ymahajan456/Peltier-and-CHIL/Images/20170119_235004.jpg

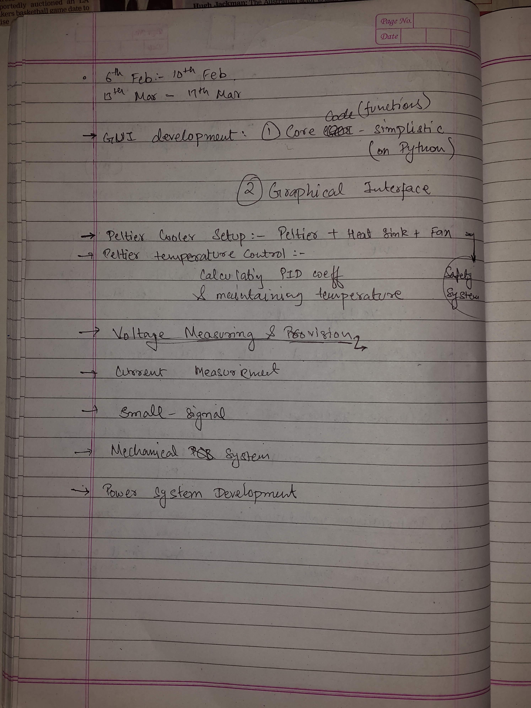
Images/20170119_235004.jpg
