ymahajan456/Peltier-and-CHIL/References/links.txt

Thermistor control of peltier voltage with Arduino (for DSLR chill box project)

http://electronics.stackexchange.com/questions/118536/thermistor-control-of-peltier-voltage-with-arduino-for-dslr-chill-box-project
.....................................................................................................................................
