ymahajan456/Peltier-and-CHIL/Documentation/Final Documentation/D16.pdf

# Temperature Controller and IV Characterizer Group Number: DD 16

## Project Guide: Prof. Joseph John

G R O U P M E M B E R S

O V S H A S H A N K 1 4 D 0 7 0 0 2 1

Y O G E S H M A H A J A N 1 4 D 0 7 0 0 2 2

A Y U S H A G R A W A L 1 4 D 0 7 0 0 4 2

# Abstract

- The aim of the project was to build a wide range temperature controller using a Peltier Cooler
- The set is to be used to plot the IV Characteristics of two terminal devices at various temperatures.
- Along with the temperature controller, the IV Characteriser was also designed as part of the project.

# Motivation

- Not an easy way to quickly characterize a devices’ characteristic at various temperatures
- Reduce the manual effort by designing an automated system
- Learn about the Peltier Cooler
- Learn precise low power system design for the IV Characteriser
- Learn coding for new microprocessors and GUI Design

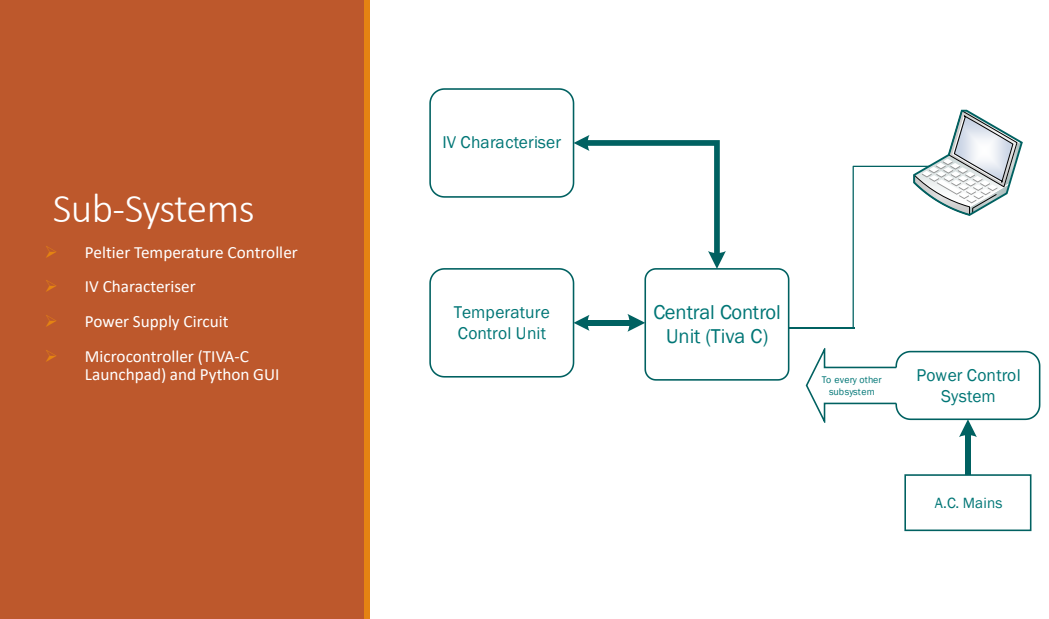
[picture p14: page 4]
Temperature Control Unit; IV Characteriser; Central Control Unit (Tiva C); Power Control System; A.C. Mains; Sub-Systems; ➢ IV Characteriser

➢ Peltier Temperature Controller

➢ Power Supply Circuit

➢ Microcontroller (TIVA-C
Launchpad) and Python GUI

To every other
subsystem

# Power Supply Circuit and TIVA Breakout

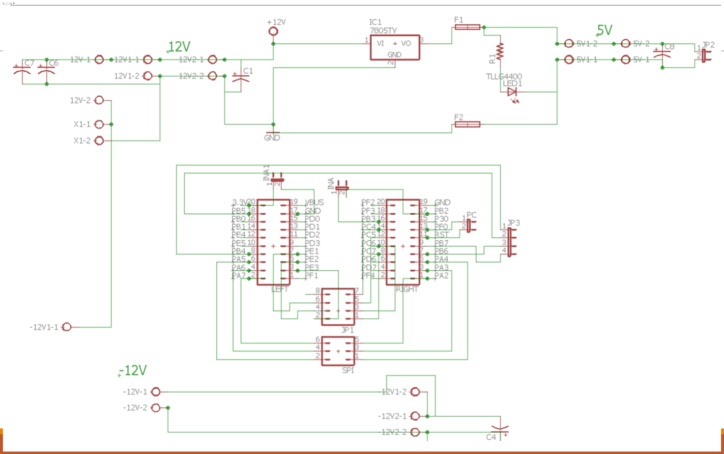
[picture p15: figure]

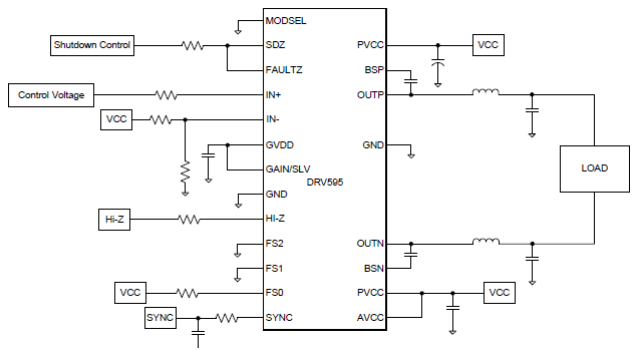
[picture p16: figure]

# DRV595

- H Bridge IC
- High Power handling capability and internal direction switching
- Testing Procedure
- Problems Faced

# Peltier Temperature Controller

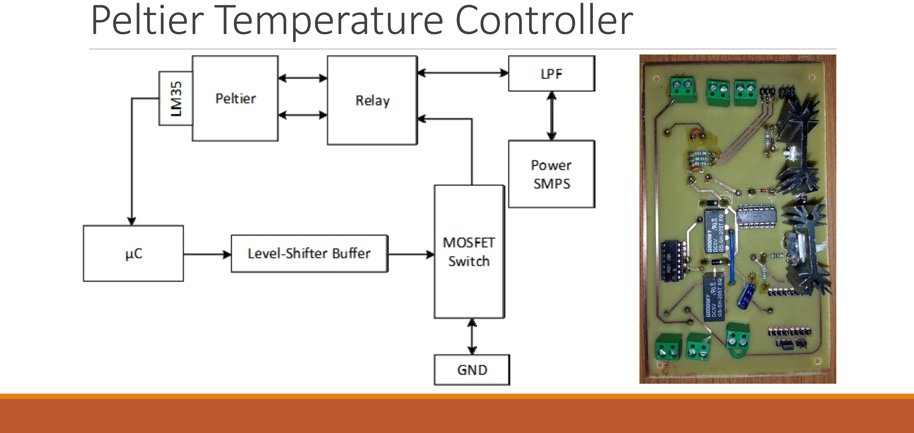
[picture p17: page 7]
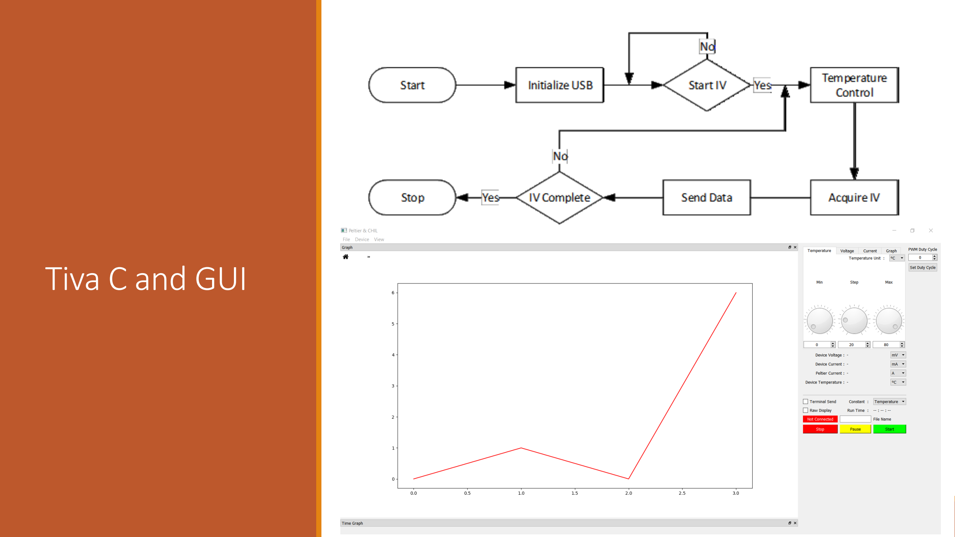
[picture p18: page 8]

# Tiva C and GUI

# IV Characteriser

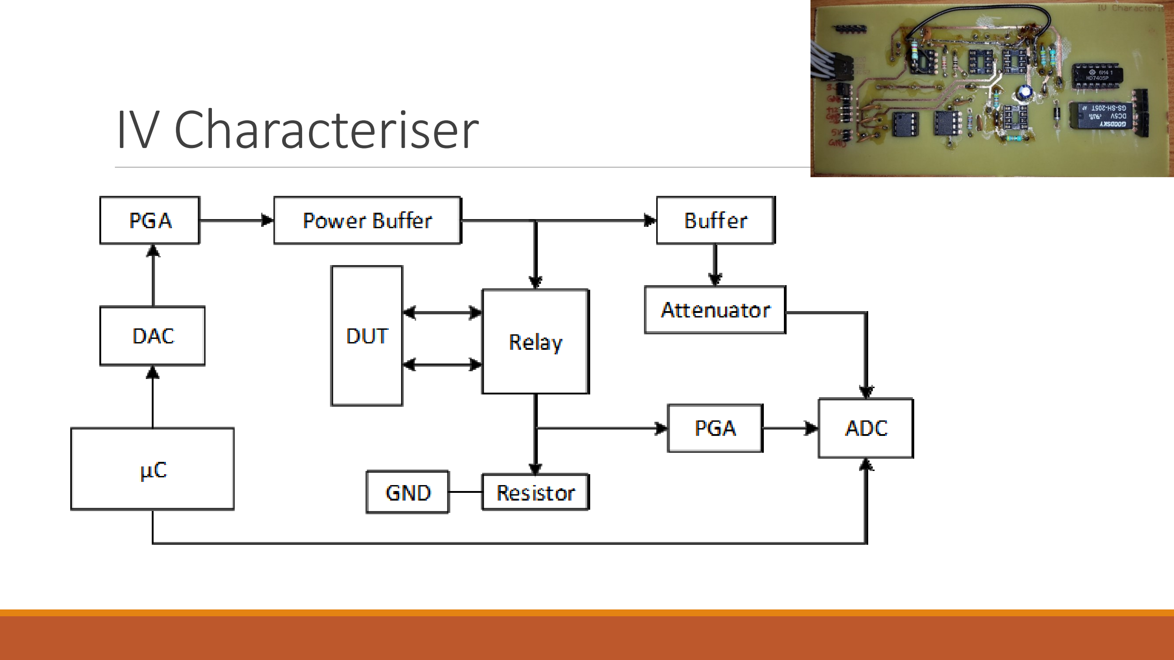
[picture p19: page 9]

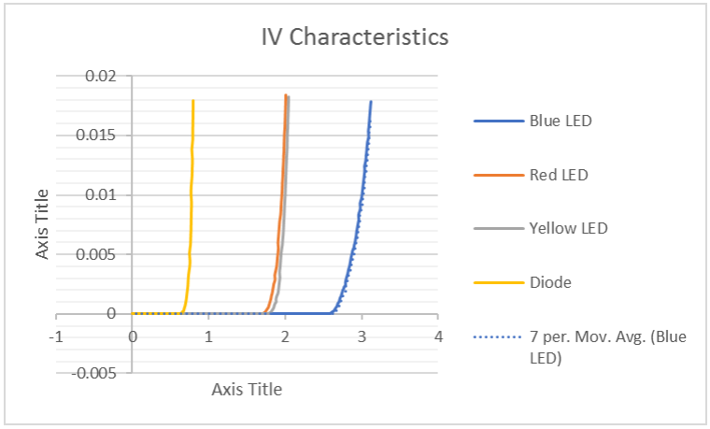
[picture p20: figure]

# Testing Results

- Peltier Temperatures were stabilised in the range of -5 degrees to 80 degrees
- Temperatures around room temperatures showed more
oscillations
- IV Characterisation was
completed and the following are the results

# Demo Details

- IV Characterisation for Diodes and Zener Diodes will be performed
- A few temperatures will be shown to stabilise along with settling time details
- Diode IV Characteristics will be plotted at a few set-point temperatures and the variation would be observed

# Future Scope

- Performing the small signal analysis of the two-terminal device
- Extend support to multi-terminal devices by applying bias to the other terminals and performing the IV Characteristics across the remaining terminals
- Temperature Control of the Peltier Cooler can be made more precise by using the double control loop
- More dynamic changes can be introduced in the IV Characteristics to make the control more robust, immune to errors and fine grained to get high standard results.
