ymahajan456/Peltier-and-CHIL/Documentation/Project Proposal/Gantt project planner.xlsx

Multi-Temperature Diode Characterizer
Unit used in the Gannt Chart is of a Day. |  |  |  |  | Period Highlight: | 1 |  |  | Plan Duration |  |  |  |  |  | Actual Start |  |  |  |  | % Complete |  |  |  |  | Actual (beyond plan) |  |  |  |  |  |  |  | % Complete (beyond plan)
ACTIVITY | PLAN START | PLAN DURATION | ACTUAL START | ACTUAL DURATION | PERCENT COMPLETE | PERIODS
 |  |  |  |  |  | 1 | 2 | 3 | 4 | 5 | 6 | 7 | 8 | 9 | 10 | 11 | 12 | 13 | 14 | 15 | 16 | 17 | 18 | 19 | 20 | 21 | 22 | 23 | 24 | 25 | 26 | 27 | 28 | 29 | 30 | 31 | 32 | 33 | 34 | 35 | 36 | 37 | 38 | 39 | 40 | 41 | 42 | 43 | 44 | 45 | 46 | 47 | 48 | 49 | 50 | 51 | 52 | 53
Peltier Cooler Setup | 1 | 3 | 0 | -1 | 25%
Component Procurement and Testing | 1 | 6 | -1 | -1 | 100%
Metal Plate Temperature Control | 4 | 3 | -1 | -1 | 35%
DUT Holder Assembly | 1 | 7 | -1 | -1 | 10%
Voltage Measurement Circuitry | 8 | 14 | -1 | -1 | 85%
Final PCB Design | 8 | 60 | -1 | -1 | 85%
Current Measurement Circuitry | 23 | 4 | -1 | -1 | 50%
GUI for I-V Characteristics | 8 | 60 | -1 | -1 | 60%
Voltage Generation Circuitry | 28 | 7 | -1 | -1 | 75%
Integrating Small Signal Analysis | 36 | 20 | -1 | -1 | 100%
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
