ymahajan456/Peltier-and-CHIL/Boards/IV_Characteristics/Schematic.png

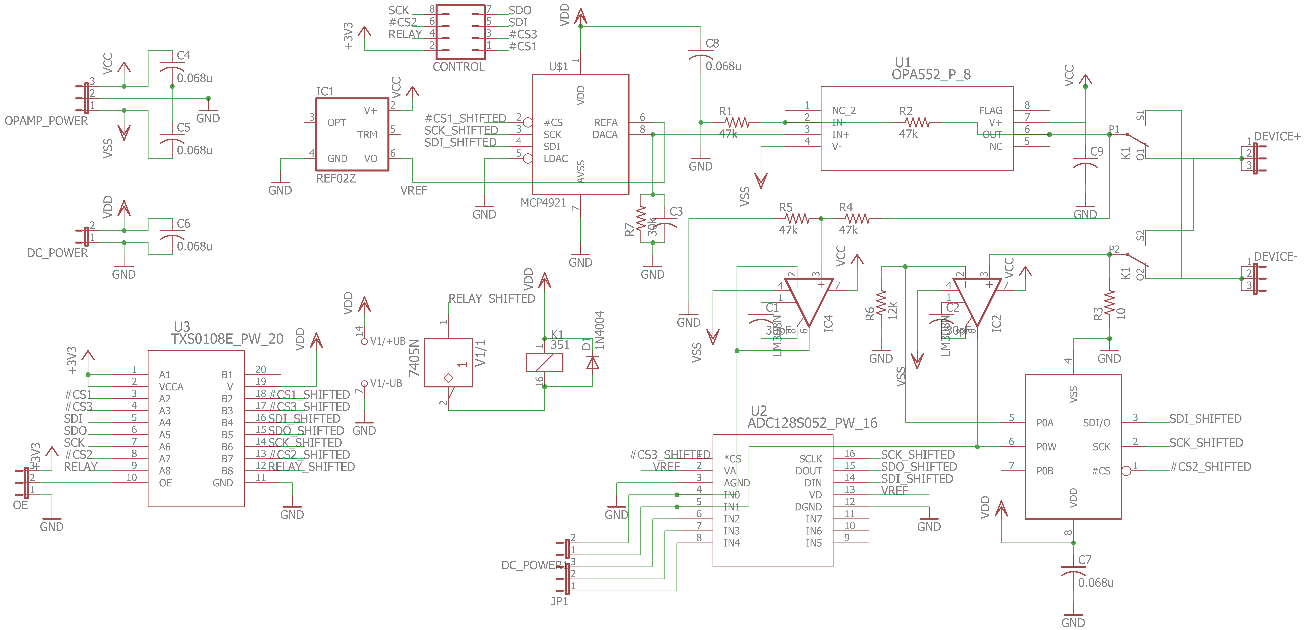
Boards/IV_Characteristics/Schematic.png
