ymahajan456/Peltier-and-CHIL/Images/20170119_234951.jpg

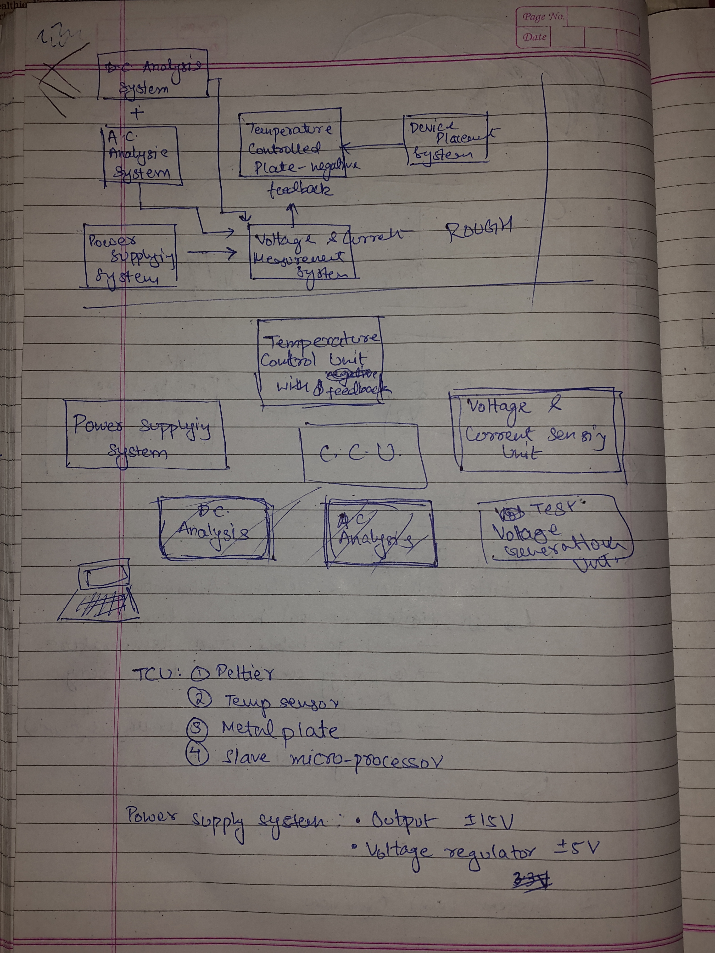
Images/20170119_234951.jpg
