ymahajan456/Peltier-and-CHIL/Images/Screenshot 2017-04-11 00.53.12.png

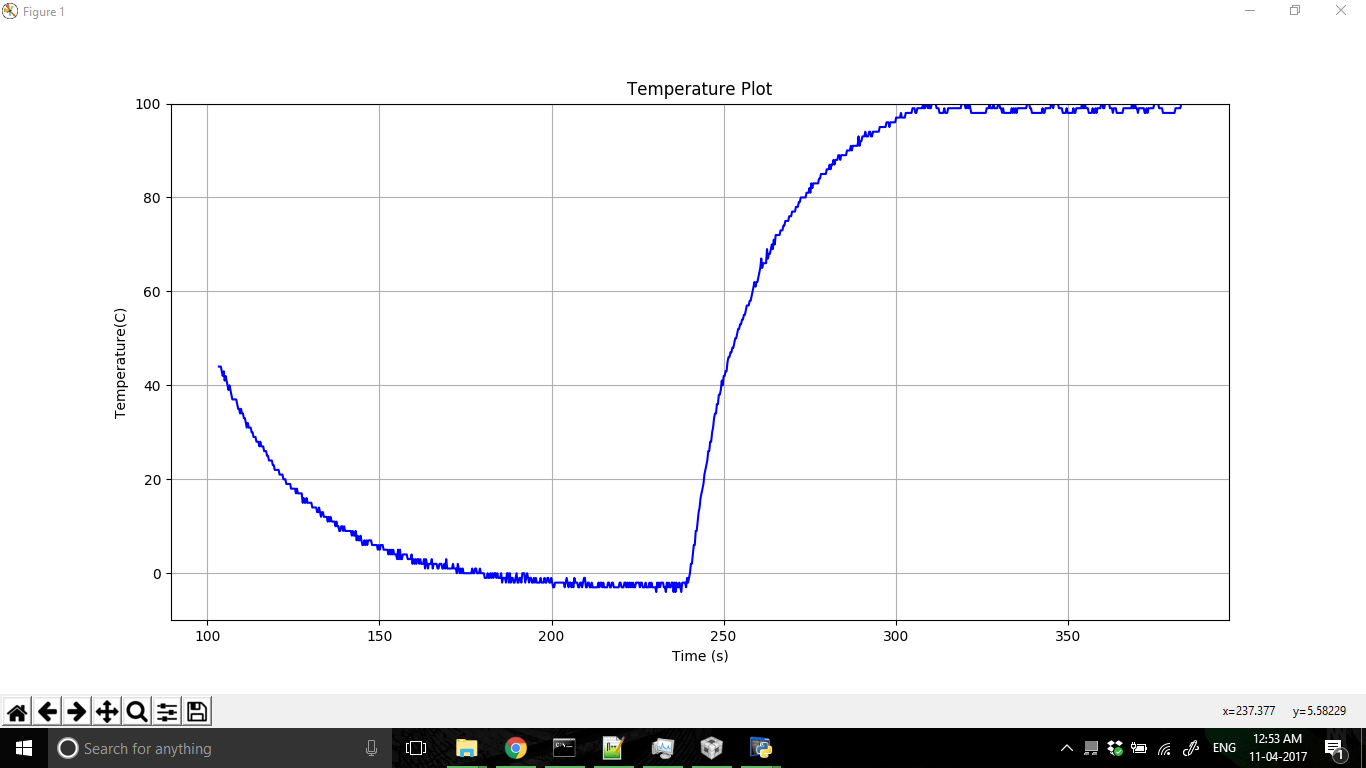
Images/Screenshot 2017-04-11 00.53.12.png
