ymahajan456/Peltier-and-CHIL/Images/Screenshot 2017-04-11 16.41.18.png

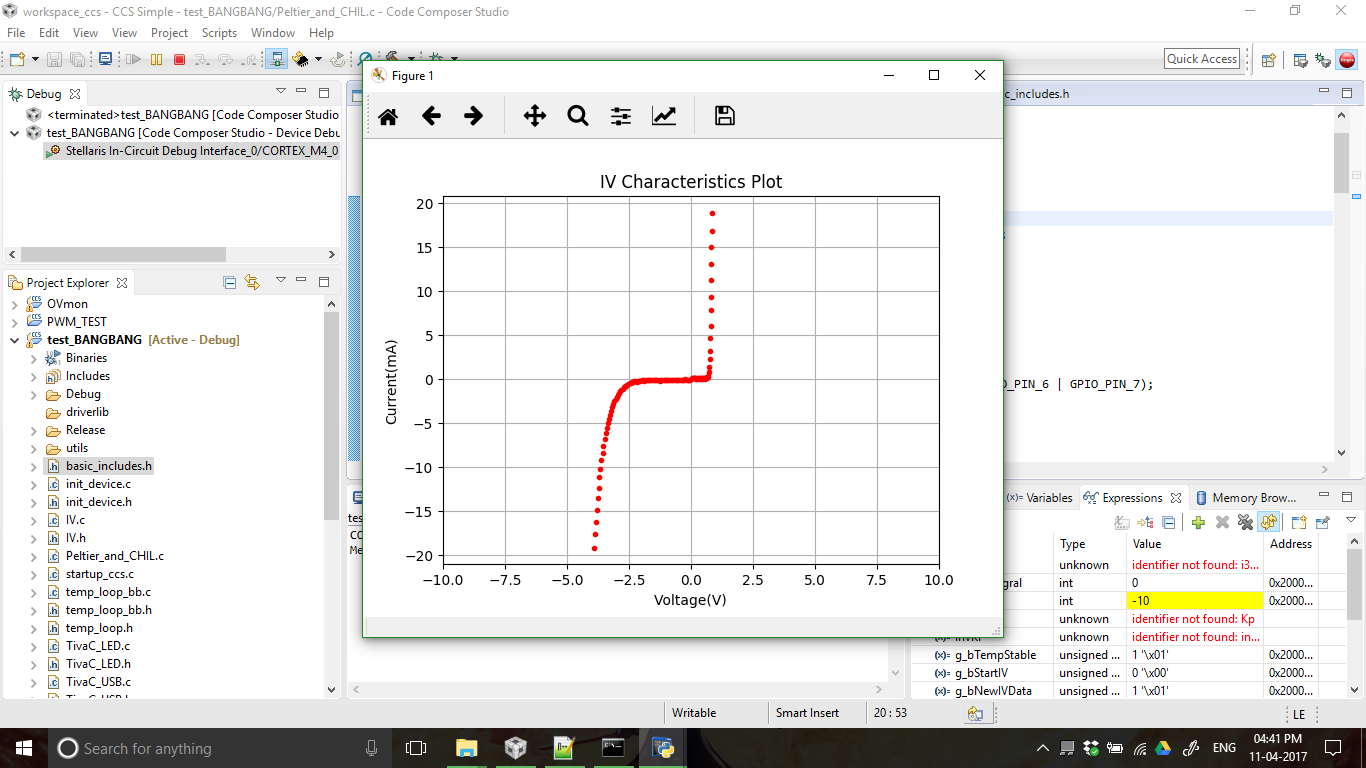
Images/Screenshot 2017-04-11 16.41.18.png
