ymahajan456/Peltier-and-CHIL/Images/theOneThatDied.jpg

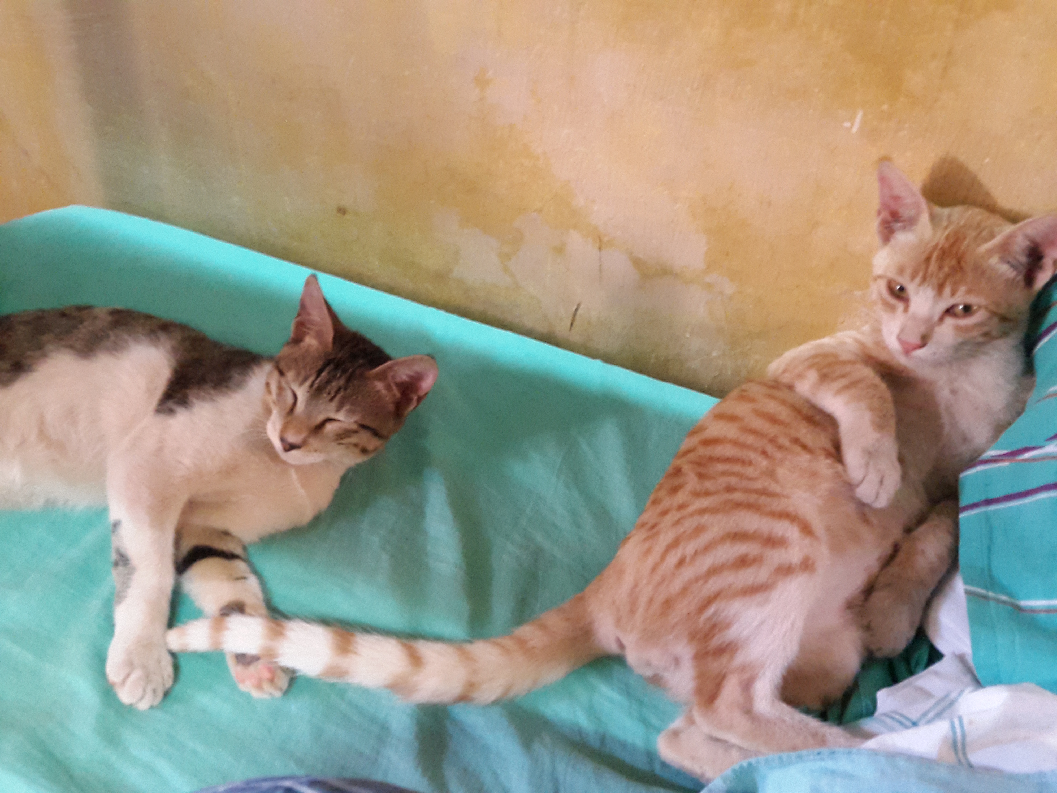
Images/theOneThatDied.jpg
