ymahajan456/Peltier-and-CHIL/Images/Zener.png

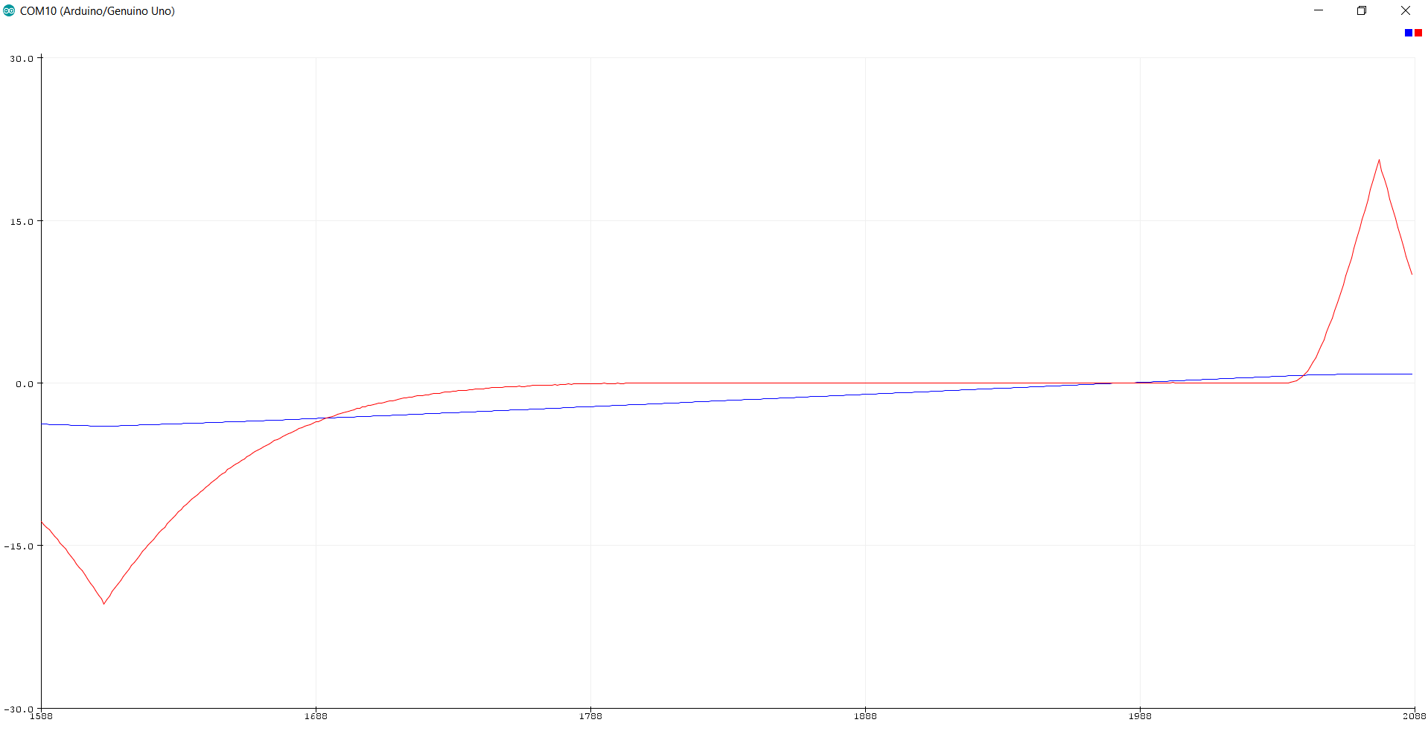
Images/Zener.png
