ymahajan456/Peltier-and-CHIL/Circuit Testing/Current Control testing/inductor_capacitor.docx

Initial circuit used for testing:

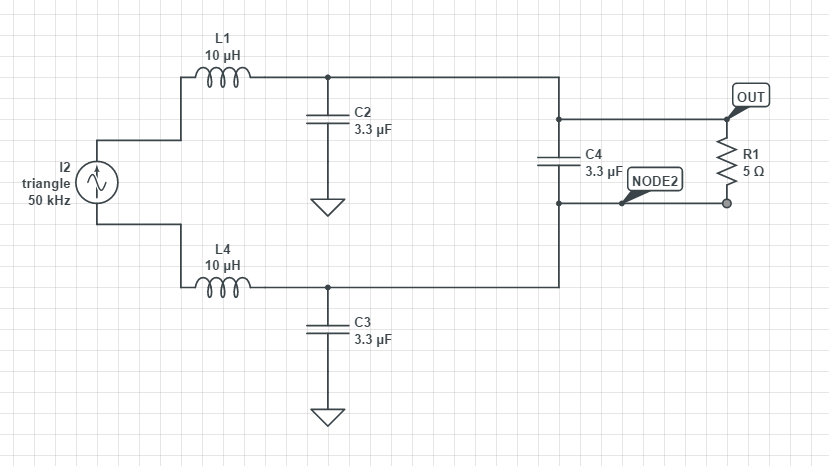
[picture p46: figure]

Current through the resistor R1:

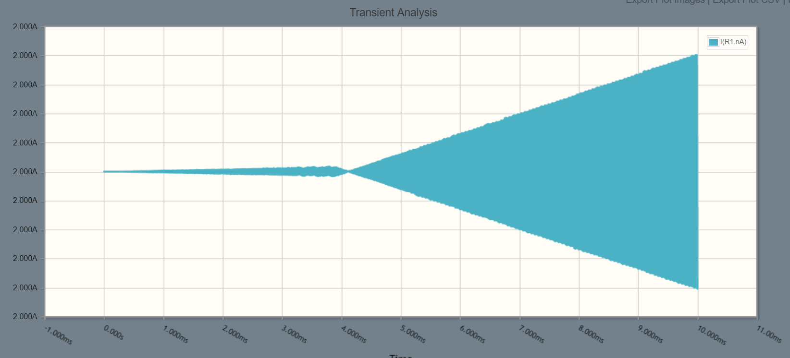
[picture p47: figure]

Note: The current Range.

On replacing the inductor by 100uH; there is almost no effect:

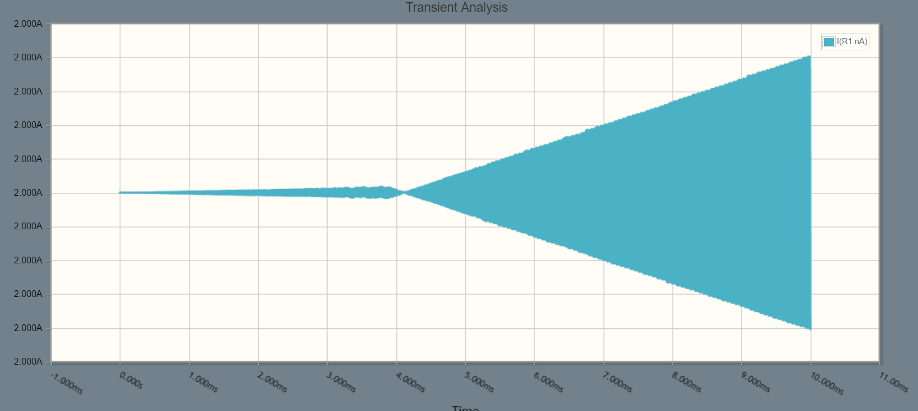
[picture p48: figure]

Making it to 33uH also does not seem to produce much effect:

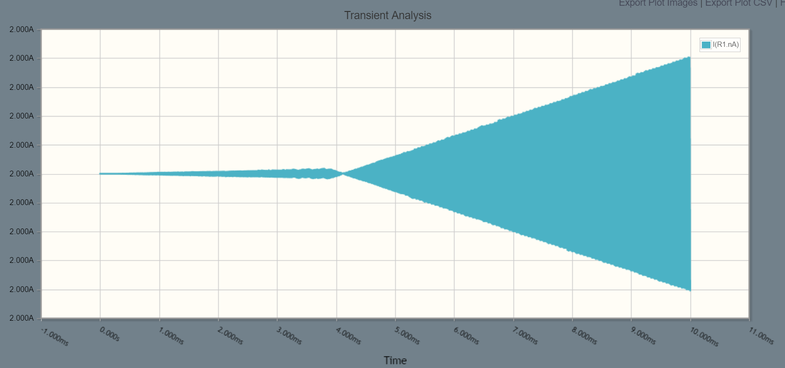
[picture p49: figure]
