ymahajan456/Peltier-and-CHIL/Boards/Test Boards/DRV595_EvaluationBoard/DRV.png

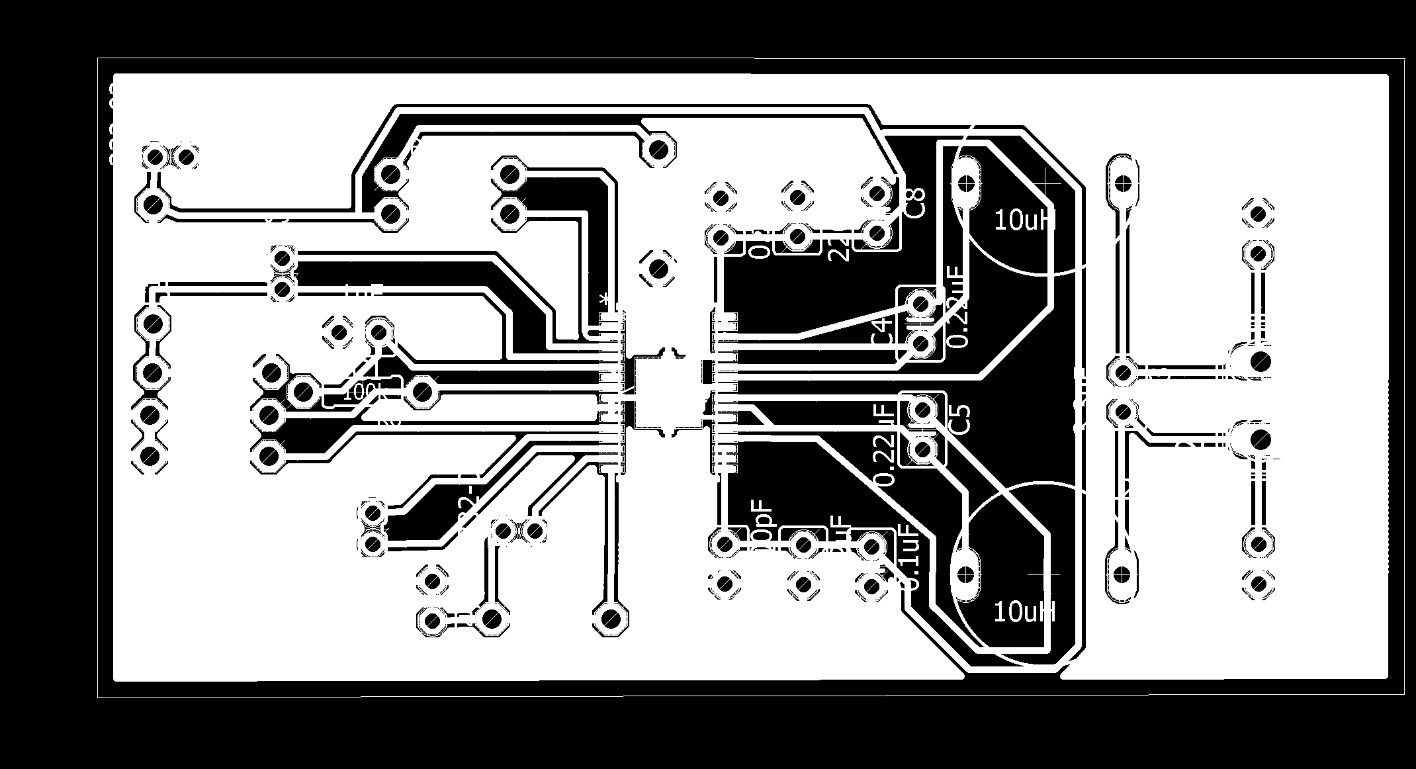
Boards/Test Boards/DRV595_EvaluationBoard/DRV.png
