ymahajan456/Peltier-and-CHIL/Boards/Test Boards/voltage_regulators/Board.png

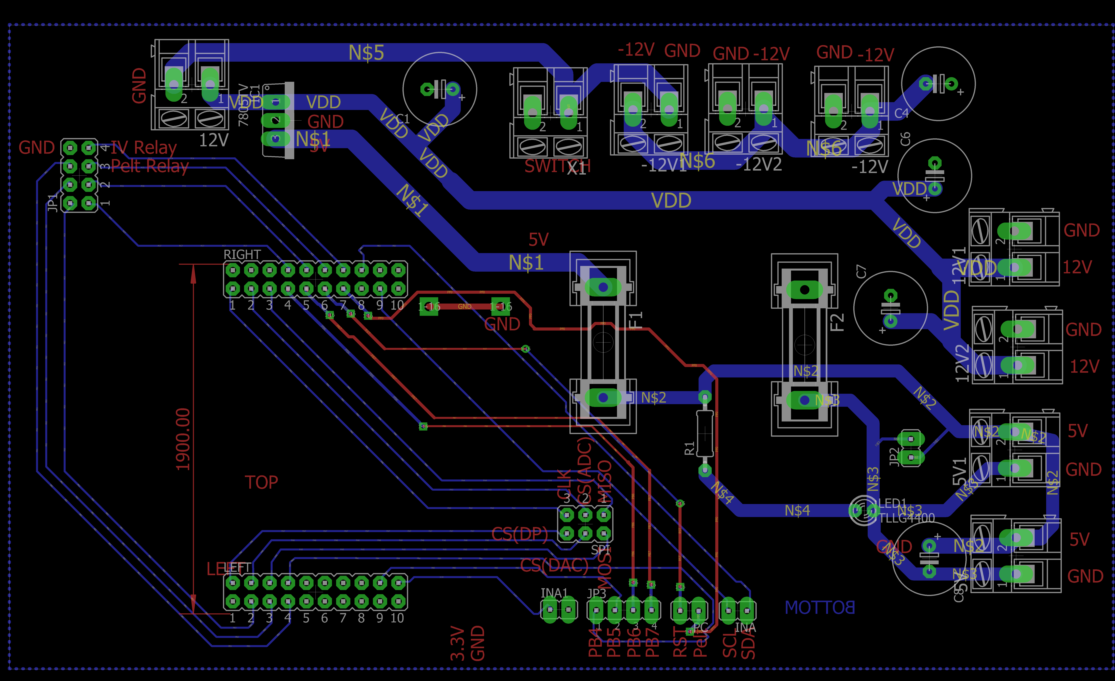
Boards/Test Boards/voltage_regulators/Board.png
