ymahajan456/Peltier-and-CHIL/Documentation/-12V Supply Board/toPrint.pdf

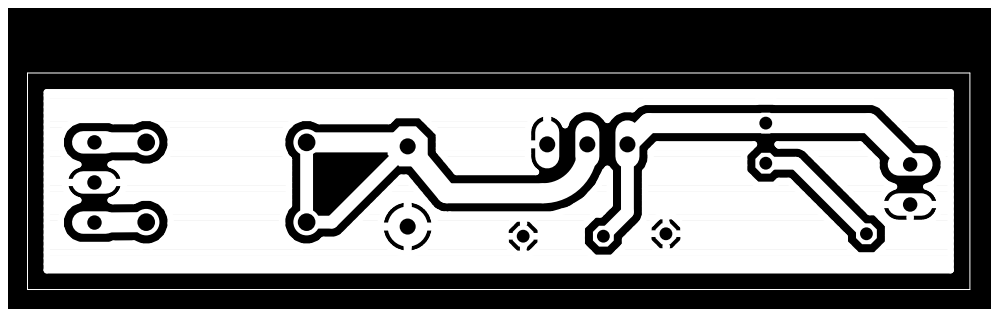
[picture p62: page 1]
