ymahajan456/Peltier-and-CHIL/Boards/Test Boards/DRV592/drv592.pdf

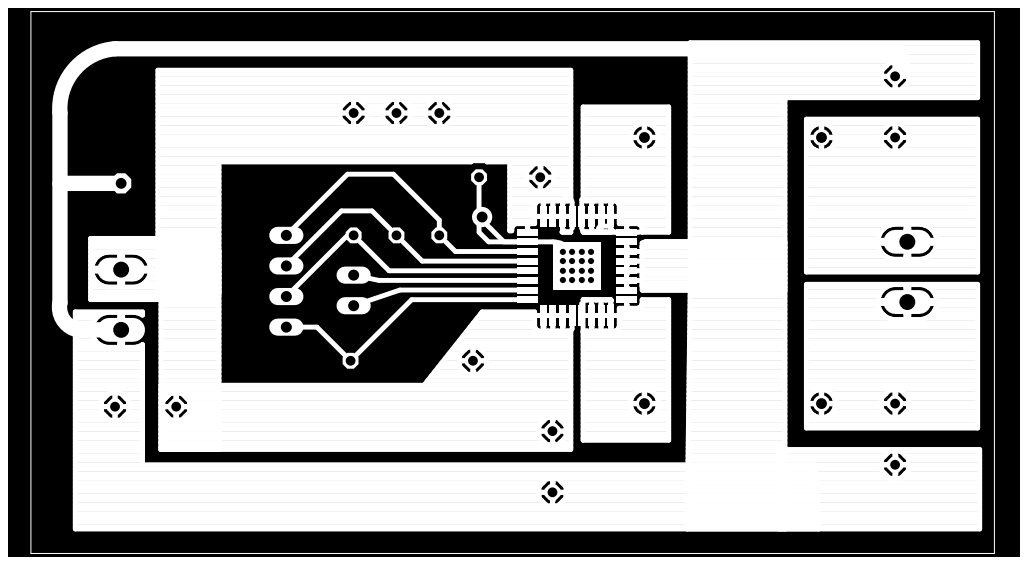
[picture p63: page 1]
