ymahajan456/Peltier-and-CHIL/Boards/Test Boards/DRV595_EvaluationBoard/drv595.pdf

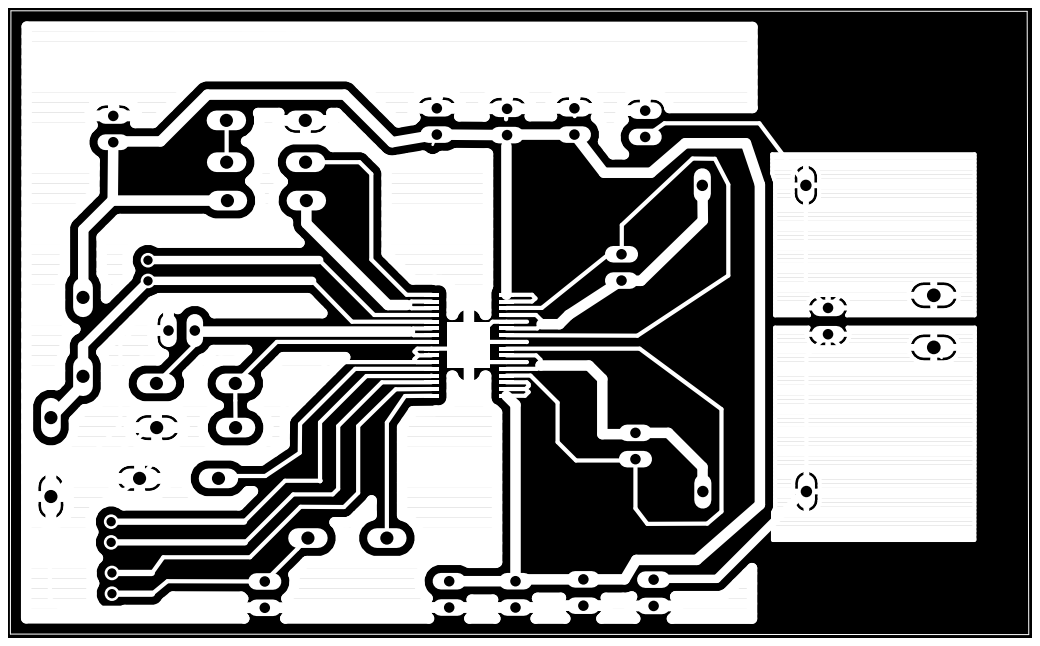
[picture p64: page 1]
