ymahajan456/Peltier-and-CHIL/Boards/Test Boards/DRV595_EvaluationBoard/drv_final.pdf

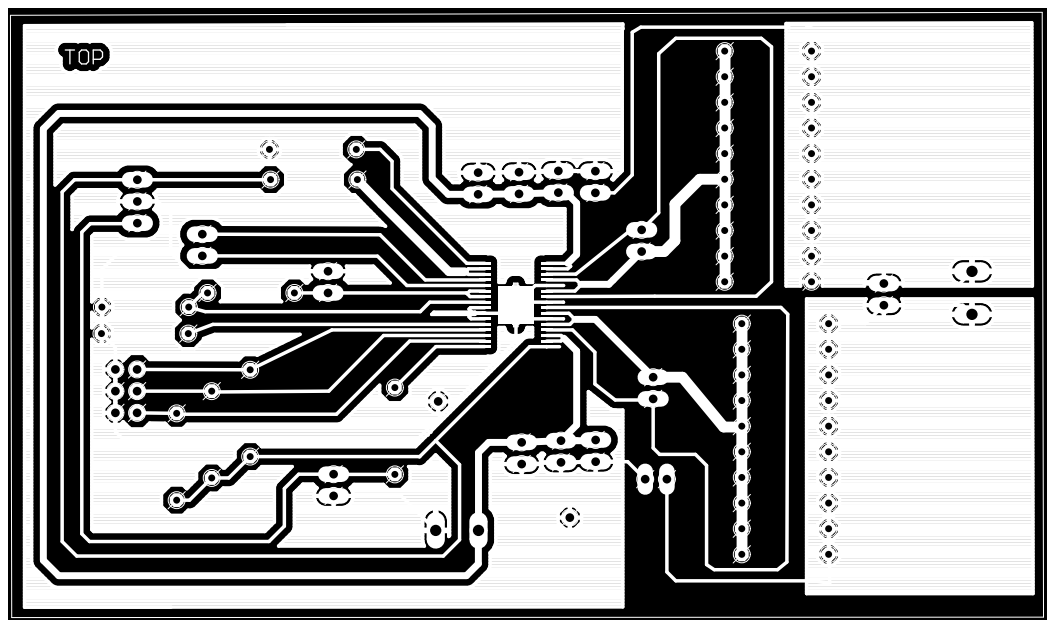
[picture p65: page 1]
