ymahajan456/Peltier-and-CHIL/Boards/Test Boards/INA260 Test Board/bottom.pdf

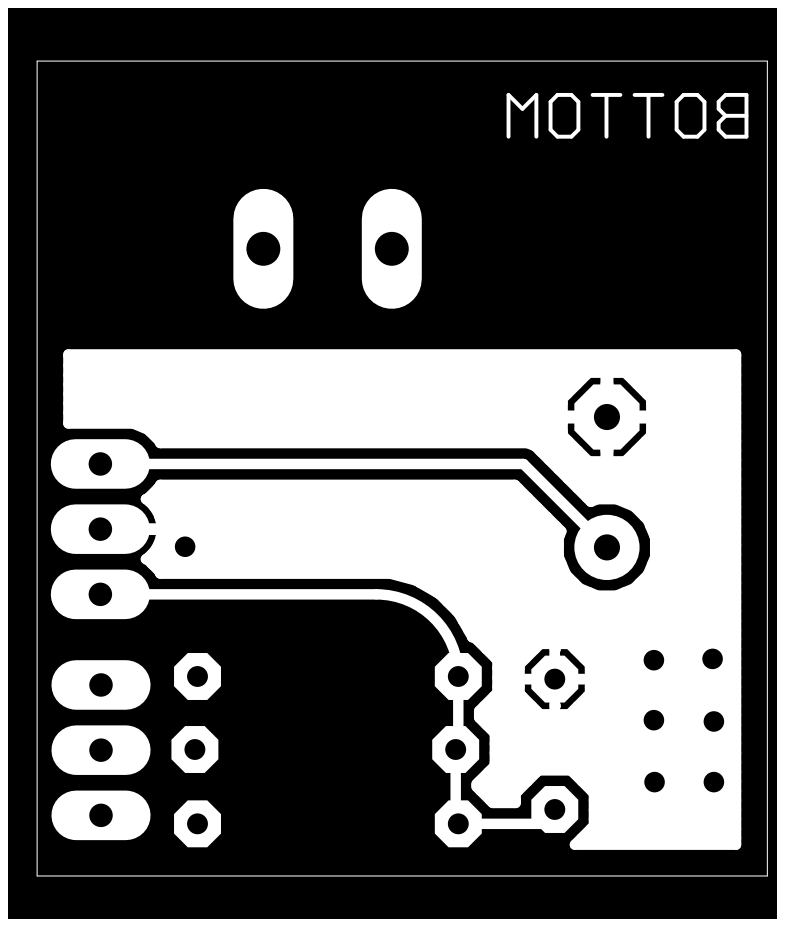
[picture p66: page 1]
