ymahajan456/Peltier-and-CHIL/Boards/Test Boards/INA260 Test Board/drv595.pdf

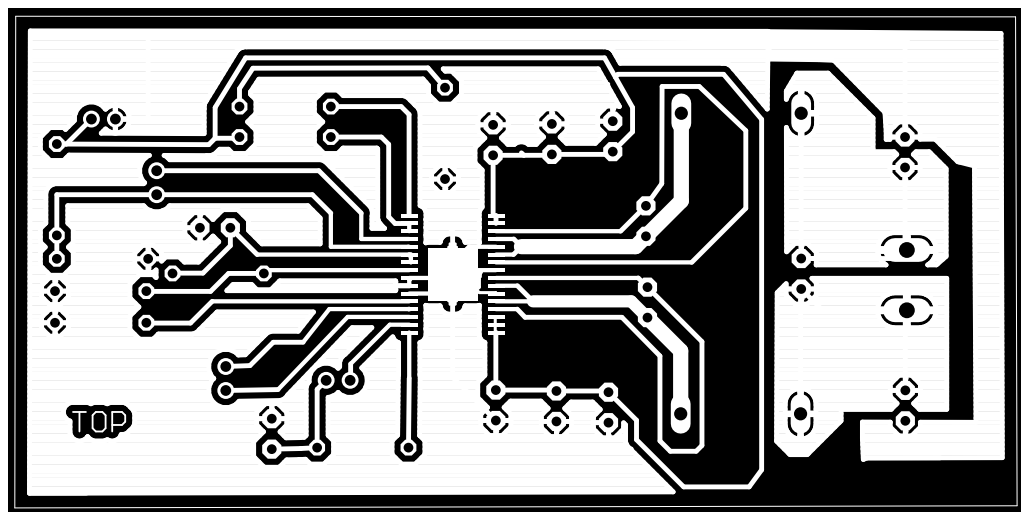
[picture p67: page 1]
