ymahajan456/Peltier-and-CHIL/Boards/Test Boards/INA260 Test Board/top.pdf

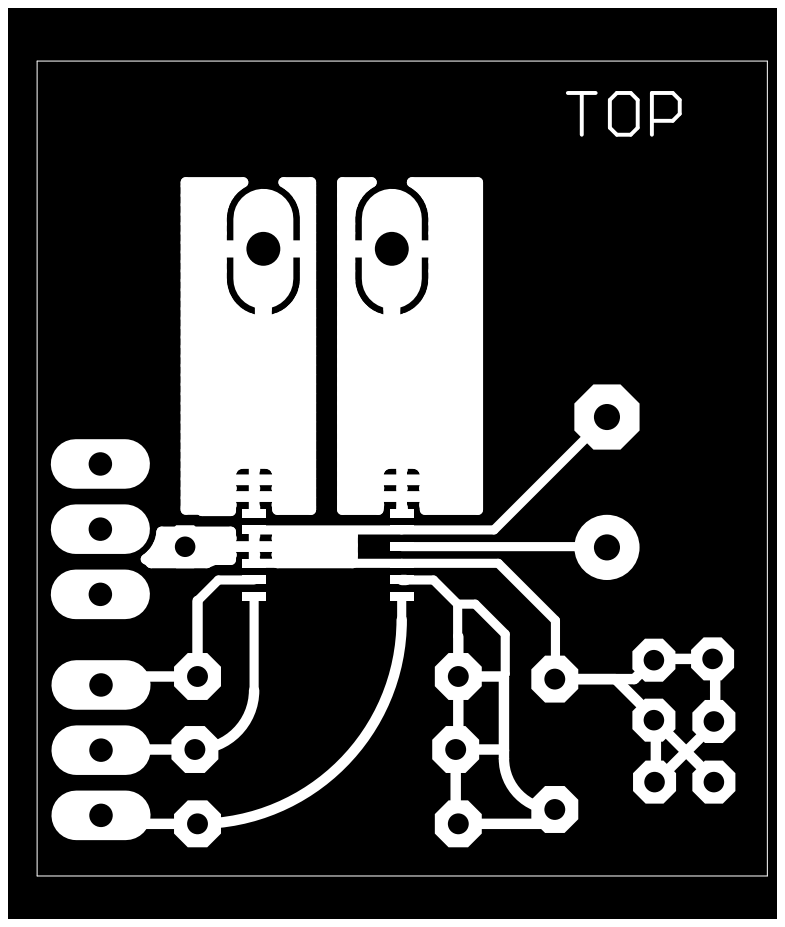
[picture p68: page 1]
