ymahajan456/Peltier-and-CHIL/Boards/Test Boards/DRV595_EvaluationBoard/DRV595.brd

## EAGLE design Boards/Test Boards/DRV595_EvaluationBoard/DRV595.brd (2018-08-11)

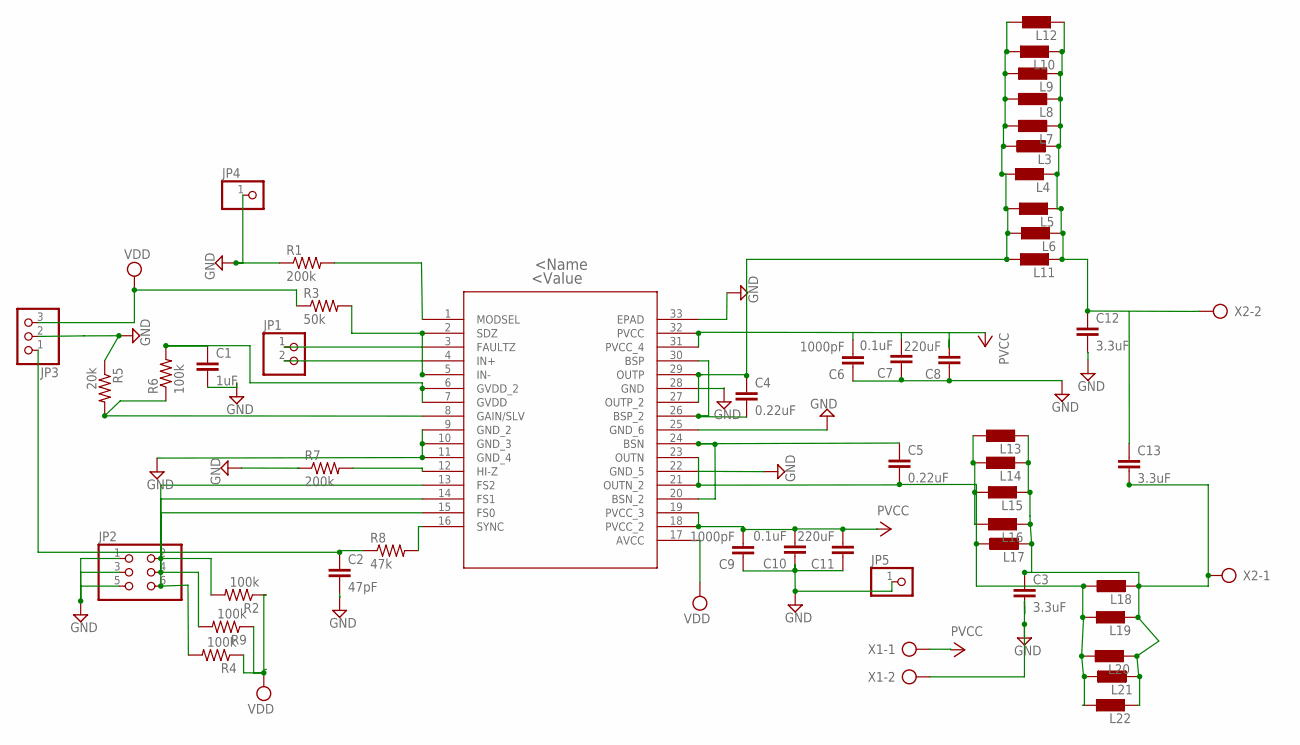
[picture p69: schematic DRV595.sch]

Parts:
C1: 1uF; C2.5-3
C2: 47pF; C2.5-3
C3, C12, C13: 3.3uF; C2.5-3
C4, C5: 0.22uF; C2.5-3
C6, C9: 1000pF; C2.5-3
C7, C10: 0.1uF; C2.5-3
C8, C11: 220uF; C2.5-3
JP1: PINHD-1X2; 1X02
JP2: PINHD-2X3; 2X03
JP3: PINHD-1X3; 1X03
JP4, JP5: PINHD-1X1; 1X01
L3, L4, L5, L6, L7, L8, L9, L10, L11, L12, L13, L14, L15, L16, L17, L18, L19, L20, L21, L22: L0207/10; 0207/10
R1, R7: 200k; 0207/10
R2, R4, R6, R9: 100k; 0207/10
R3: 50k; 0207/10
R5: 20k; 0207/10
R8: 47k; 0207/10
U1: DRV595DAPRDAP32_4P11X4P36-L; DAP32_4P11X4P36-L
X1: AK300/2
X2: AK500/2-H

Connections:
GND: C1.2, C2.2, C3.2, C6.1, C7.1, C8.1, C9.1, C10.1, C11.1, C12.2, JP2.1, JP2.3, JP2.5, JP3.2, JP4.1, JP5.1, R1.1, R5.1, R7.1, U1.9 (GND_2), U1.10 (GND_3), U1.11 (GND_4), U1.22 (GND_5), U1.25 (GND_6), U1.28 (GND), U1.33 (EPAD), X1.2
unnamed: R1.2, U1.1 (MODSEL)
unnamed: JP1.1, U1.4 (IN+)
unnamed: R3.2, U1.2 (SDZ), U1.3 (FAULTZ)
unnamed: R5.2, R6.1, U1.8 (GAIN/SLV)
unnamed: C1.1, R6.2, U1.6 (GVDD_2), U1.7 (GVDD)
unnamed: R7.2, U1.12 (HI-Z)
unnamed: R8.2, U1.16 (SYNC)
unnamed: C2.1, JP3.1, R8.1
unnamed: JP2.2, R2.2, U1.13 (FS2)
unnamed: C5.1, U1.20 (BSN_2), U1.24 (BSN)
unnamed: C4.2, U1.26 (BSP_2), U1.30 (BSP)
unnamed: JP2.4, R9.2, U1.14 (FS1)
unnamed: JP1.2, U1.5 (IN-)
unnamed: JP2.6, R4.2, U1.15 (FS0)
unnamed: C3.1, C13.2, L13.2, L14.2, L15.2, L16.2, L17.2, L18.2, L19.2, L20.2, L21.2, L22.2, X2.1
unnamed: C12.1, C13.1, L3.2, L4.2, L5.2, L6.2, L7.2, L8.2, L9.2, L10.2, L11.2, L12.2, X2.2
unnamed: C5.2, L13.1, L14.1, L15.1, L16.1, L17.1, L18.1, L19.1, L20.1, L21.1, L22.1, U1.21 (OUTN_2), U1.23 (OUTN)
unnamed: C4.1, L3.1, L4.1, L5.1, L6.1, L7.1, L8.1, L9.1, L10.1, L11.1, L12.1, U1.27 (OUTP_2), U1.29 (OUTP)
VCC: C6.2, C7.2, C8.2, C9.2, C10.2, C11.2, U1.18 (PVCC_2), U1.19 (PVCC_3), U1.31 (PVCC_4), U1.32 (PVCC), X1.1
VDD: JP3.3, R2.1, R3.1, R4.1, R9.1, U1.17 (AVCC)

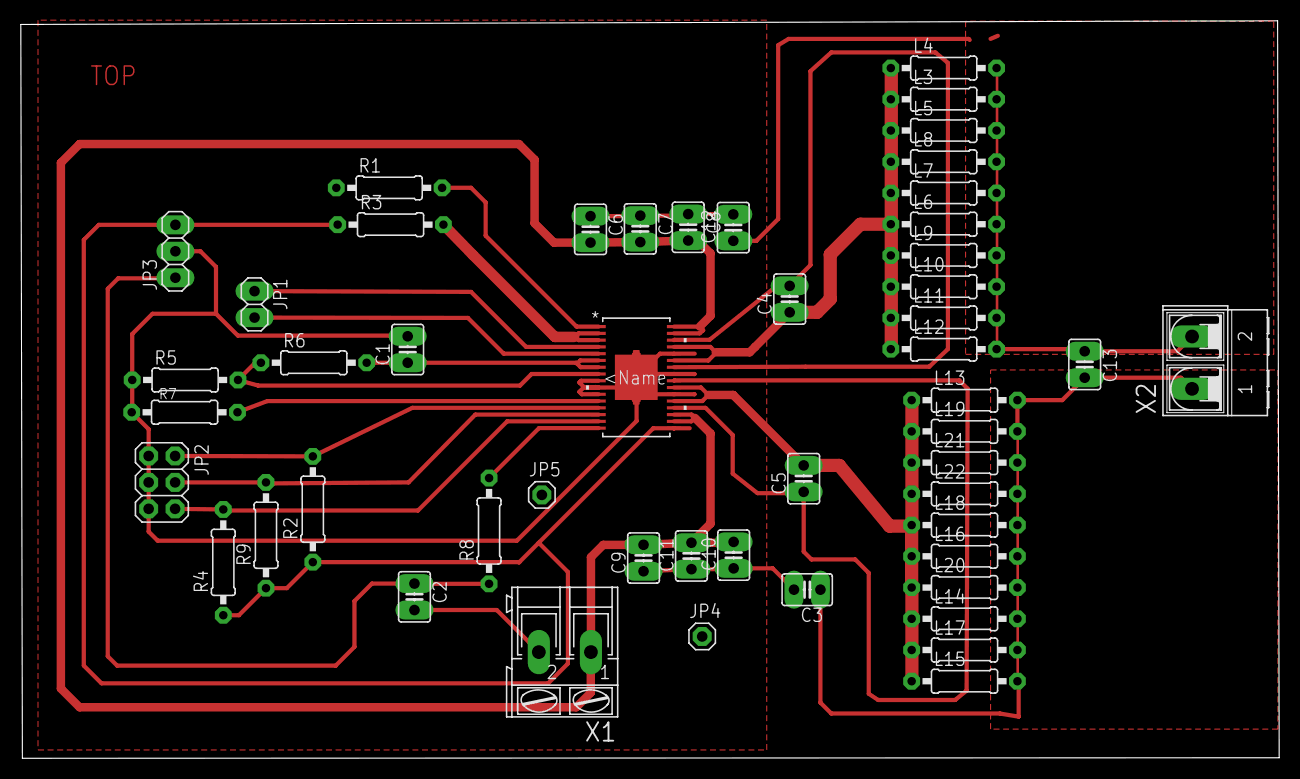
[picture p70: board DRV595.brd from above]

Board: 2 copper layers, 120.9 x 70.8 mm, 50 parts (0 on the bottom side), 21 nets.
