ymahajan456/Peltier-and-CHIL/Documentation/-12V Supply Board/schematic.brd

## EAGLE design Documentation/-12V Supply Board/schematic.brd (2018-08-11)

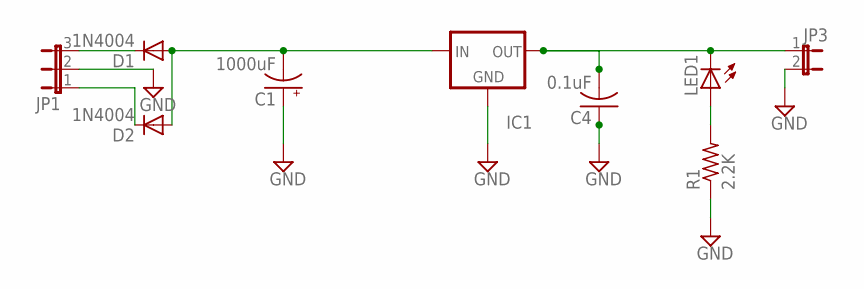
[picture p71: schematic schematic.sch]

Parts:
C1: 1000uF; E5-10,5
C4: 0.1uF; C050-025X075
D1, D2: 1N4004; DO41-10
IC1: 79XXS
JP1: JP2E; JP2
JP3: JP1E; JP1
LED1: LED5MM
R1: 2.2K; 0309/12

Connections:
GND: C1.+, C4.1, IC1.GND, JP1.2, JP3.2, R1.1
unnamed: D1.C, JP1.3
unnamed: D2.C, JP1.1
unnamed: C1.-, D1.A, D2.A, IC1.IN
unnamed: LED1.A, R1.2
unnamed: C4.2, IC1.OUT, JP3.1, LED1.K (C)

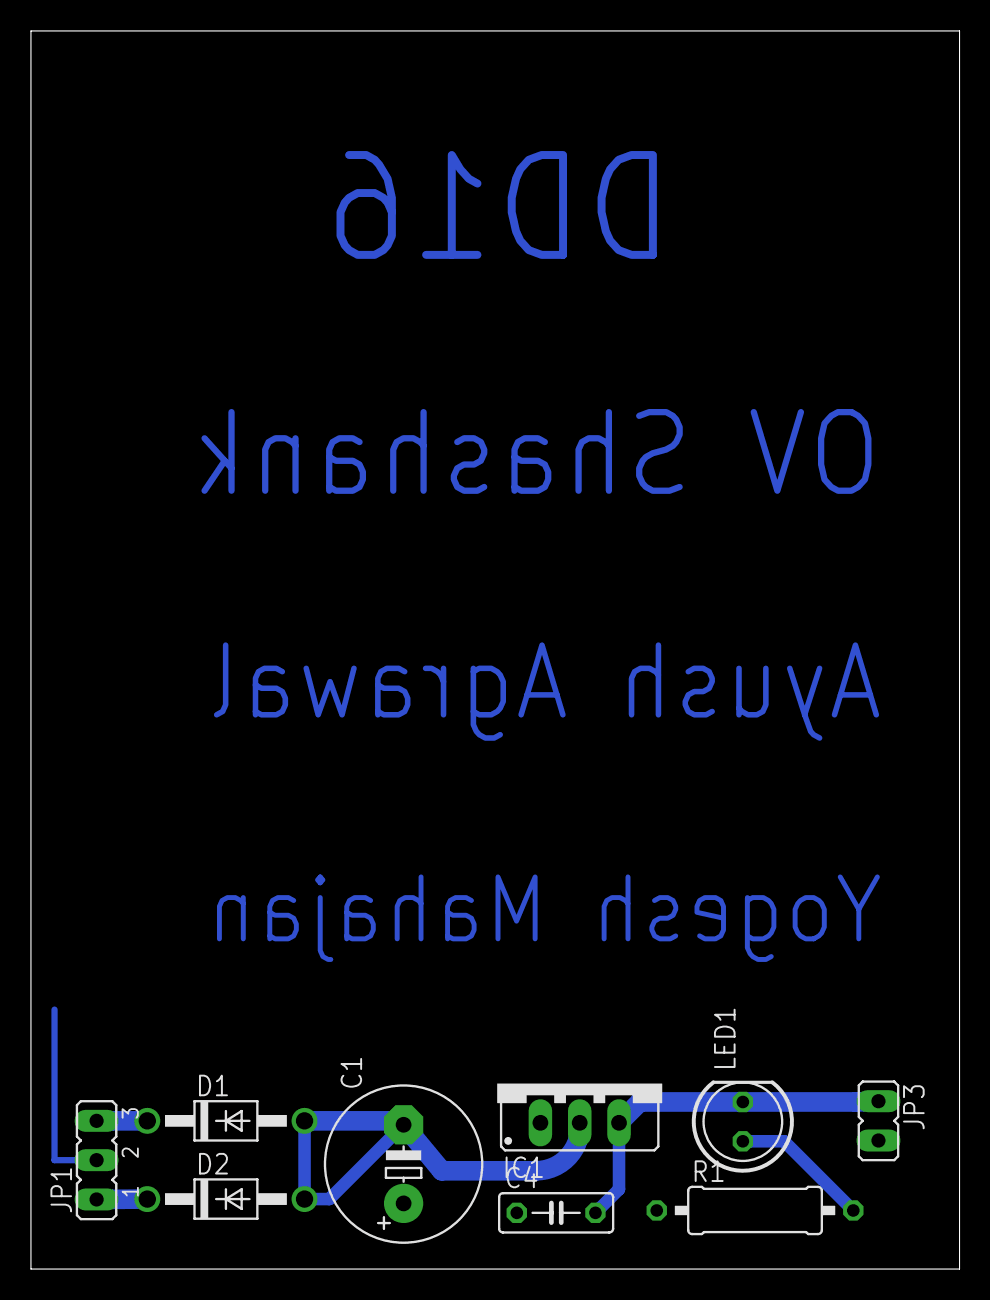
[picture p72: board schematic.brd from above]

Board: 2 copper layers, 60.0 x 80.0 mm, 9 parts (0 on the bottom side), 6 nets.
