ymahajan456/Peltier-and-CHIL/Boards/Test Boards/power_supply/lm25010.brd

## EAGLE design Boards/Test Boards/power_supply/lm25010.brd (2018-08-11)

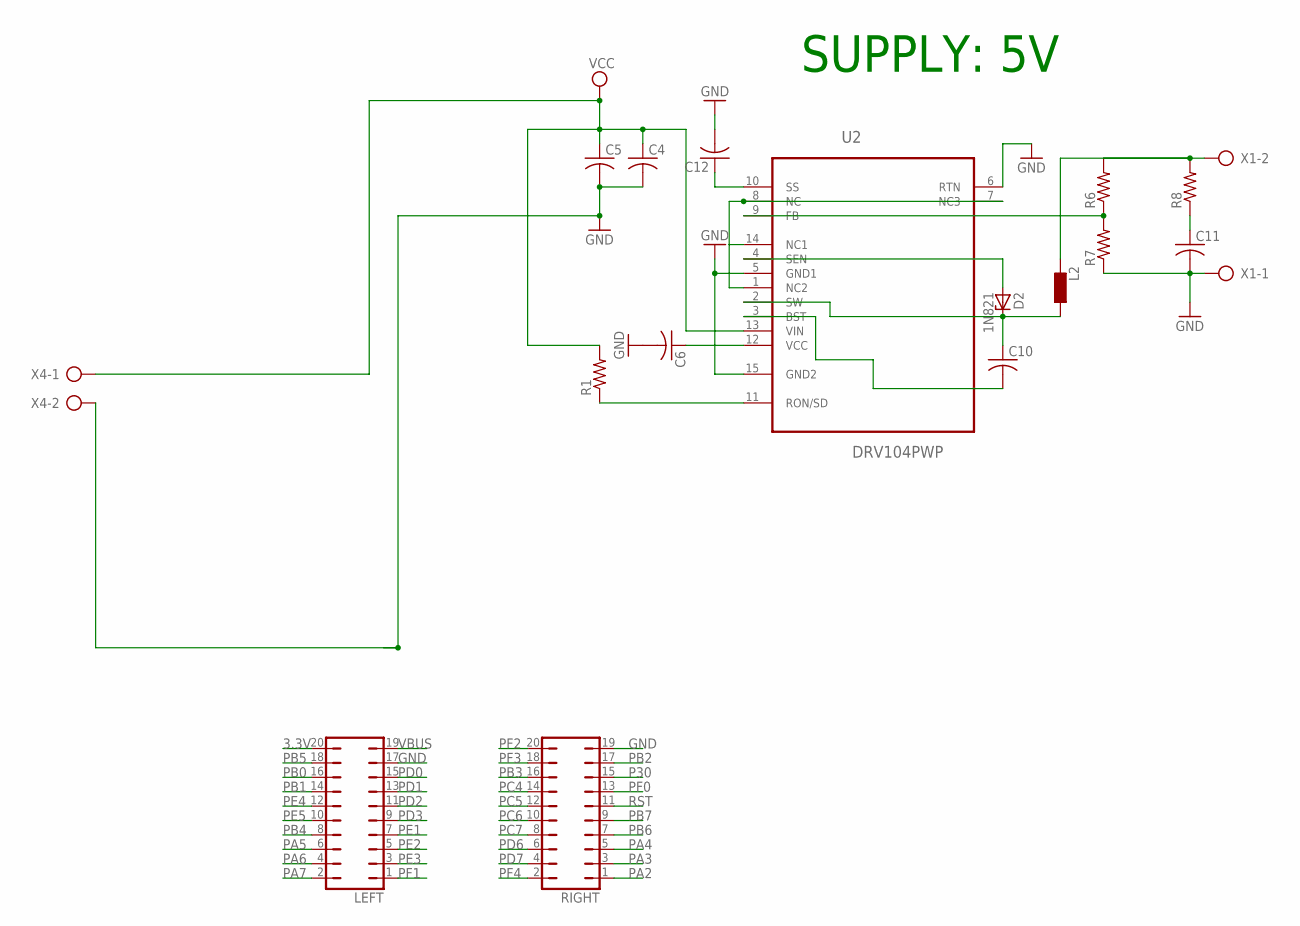
[picture p73: schematic lm25010.sch]

Parts:
C4, C5, C6, C10, C11, C12: C-US025-024X044; C025-024X044
D2: 1N821; DO35Z10
L2: L0207/10; 0207/10
LEFT: JP10Q
R1, R6, R7, R8: R-US_0207/10; 0207/10
RIGHT: JP10Q
U2: DRV104PWP; SOP65P640X120-15N
X1, X4: AK300/2

Connections:
3.3V: LEFT.20
GND: C4.2, C5.2, C6.2, C11.2, C12.2, LEFT.17, R7.1, RIGHT.19, U2.5 (GND1), U2.6 (RTN), U2.15 (GND2), X1.1, X4.2
unnamed: U2.1 (NC2), U2.7 (NC3), U2.8 (NC), U2.14 (NC1)
unnamed: R1.1, U2.11 (RON/SD)
unnamed: C12.1, U2.10 (SS)
unnamed: C6.1, U2.12 (VCC)
unnamed: C11.1, R8.1
unnamed: L2.2, R6.2, R8.2, X1.2
unnamed: R6.1, R7.2, U2.9 (FB)
unnamed: D2.A, U2.4 (SEN)
unnamed: C10.1, D2.C, L2.1, U2.2 (SW)
unnamed: C10.2, U2.3 (BST)
P30: RIGHT.15
PA2: RIGHT.1
PA3: RIGHT.3
PA4: RIGHT.5
PA5: LEFT.6
PA6: LEFT.4
PA7: LEFT.2
PB0: LEFT.16
PB1: LEFT.14
PB2: RIGHT.17
PB3: RIGHT.16
PB4: LEFT.8
PB5: LEFT.18
PB6: RIGHT.7
PB7: RIGHT.9
PC4: RIGHT.14
PC5: RIGHT.12
PC6: RIGHT.10
PC7: RIGHT.8
PD0: LEFT.15
PD1: LEFT.13
PD2: LEFT.11
PD3: LEFT.9
PD6: RIGHT.6
PD7: RIGHT.4
PE1: LEFT.7
PE2: LEFT.5
PE3: LEFT.3
PE4: LEFT.12
PE5: LEFT.10
PF0: RIGHT.13
PF1: LEFT.1
PF2: RIGHT.20
PF3: RIGHT.18
PF4: RIGHT.2
RST: RIGHT.11
VBUS: LEFT.19
VCC: C4.1, C5.1, R1.2, U2.13 (VIN), X4.1

Notes on the sheet:
SUPPLY: 5V

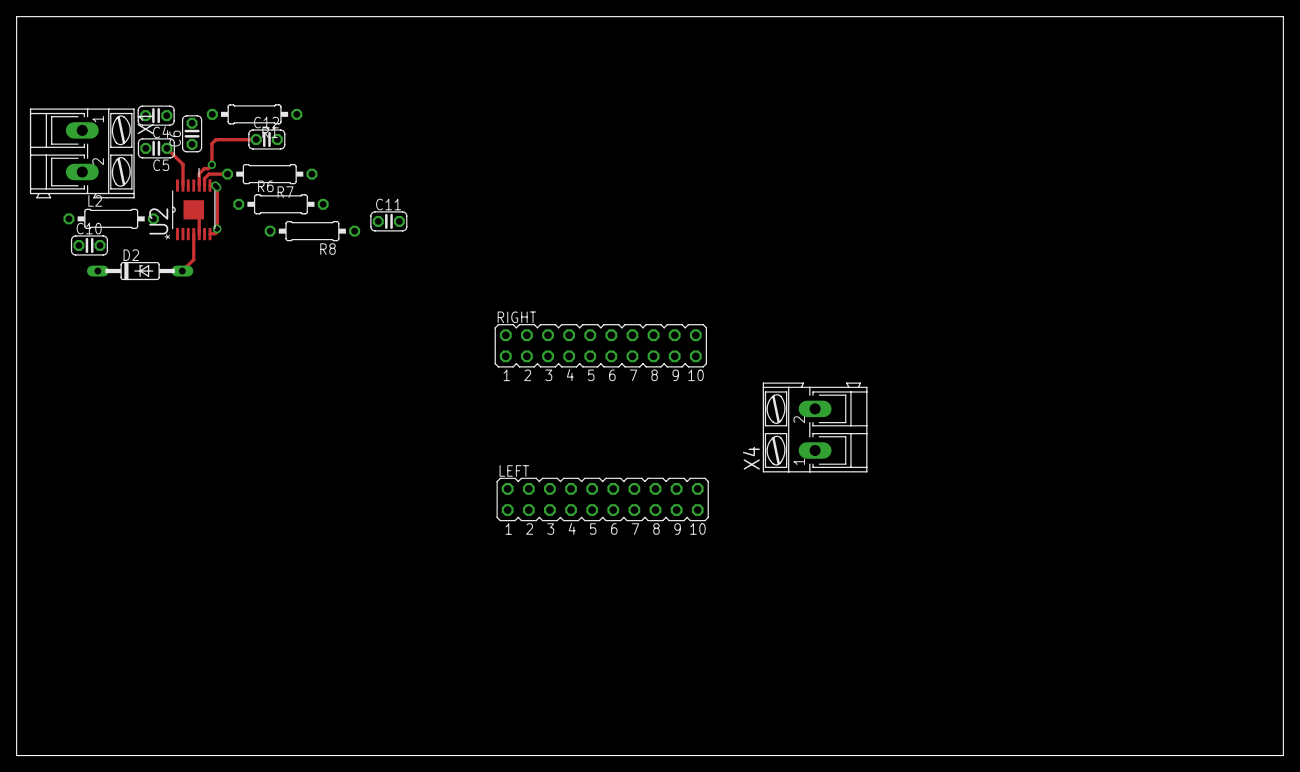
[picture p74: board lm25010.brd from above]

Board: 2 copper layers, 152.4 x 88.9 mm, 17 parts (0 on the bottom side), 12 nets.
