ymahajan456/Peltier-and-CHIL/Boards/Test Boards/INA260 Test Board/INA260_TB.brd

## EAGLE design Boards/Test Boards/INA260 Test Board/INA260_TB.brd (2018-08-11)

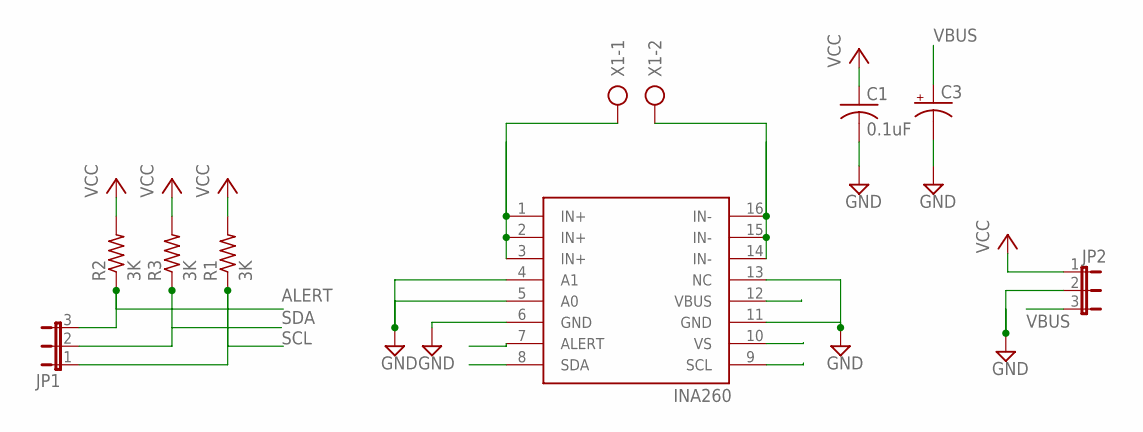
[picture p75: schematic INA260_TB.sch]

Parts:
C1: 0.1uF; C050-025X075
C3: CPOL-USE5-10.5; E5-10,5
JP1, JP2: JP2E; JP2
R1, R2, R3: 3K; 0207/10
U$1: INA260; TSSOP16
X1: AK300/2

Connections:
ALERT: JP1.3, R2.1, U$1.7 (ALERT)
GND: C1.2, C3.-, JP2.2, U$1.4 (A1), U$1.5 (A0), U$1.6 (GND), U$1.11 (GND), U$1.13 (NC)
unnamed: U$1.1 (IN+), U$1.2 (IN+), U$1.3 (IN+), X1.1
unnamed: U$1.14 (IN-), U$1.15 (IN-), U$1.16 (IN-), X1.2
SCL: JP1.1, R1.1, U$1.9 (SCL)
SDA: JP1.2, R3.1, U$1.8 (SDA)
VBUS: C3.+, JP2.3, U$1.12 (VBUS)
VCC: C1.1, JP2.1, R1.2, R2.2, R3.2, U$1.10 (VS)

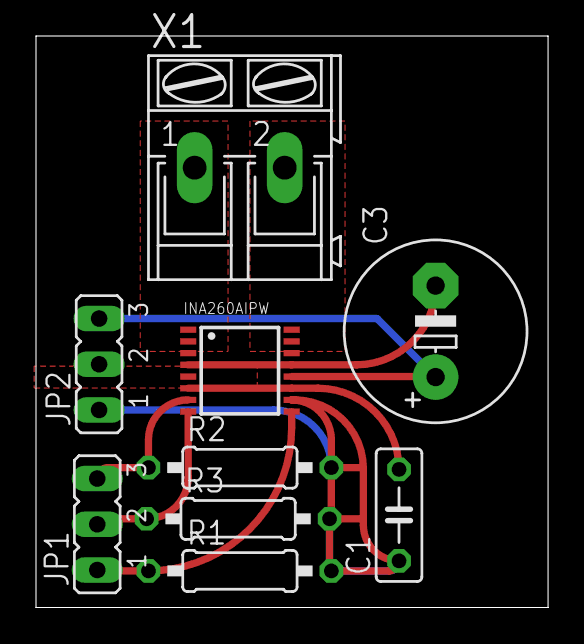
[picture p76: board INA260_TB.brd from above]

Board: 2 copper layers, 28.4 x 31.8 mm, 9 parts (0 on the bottom side), 8 nets.
