ymahajan456/Peltier-and-CHIL/Boards/Peltier_Controller/Peltier_Controller.brd

## EAGLE design Boards/Peltier_Controller/Peltier_Controller.brd (2018-08-11)

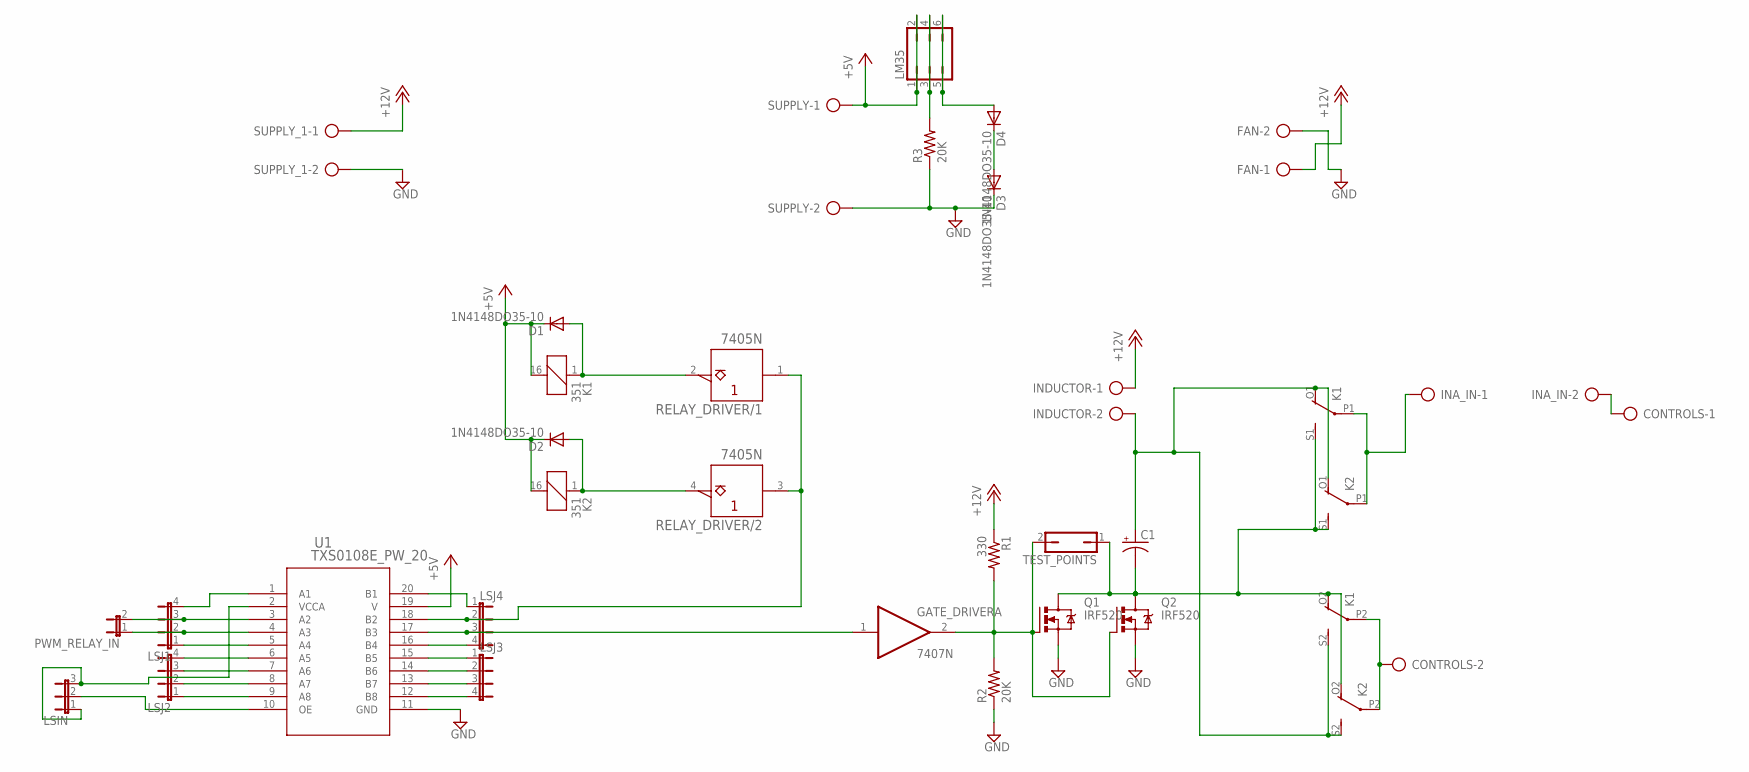
[picture p77: schematic Peltier_Controller.sch, sheet 1]

Parts:
C1: CPOL-USTT6D6; TT5D6
CONTROLS: AK500/2-H
D1, D2, D3, D4: 1N4148DO35-10; DO35-10
FAN: AK500/2-H
GATE_DRIVER: 7407N; DIL14
INA_IN: AK500/2-H
INDUCTOR: AK500/2-H
K1, K2: 351
LM35: JP3Q
LSIN: JP2E; JP2
LSJ1, LSJ2, LSJ3, LSJ4: JP4E; JP4
PWM_RELAY_IN: JP1E; JP1
Q1, Q2: IRF520; TO220BV
R1: 330; 0207/12
R2, R3: 20K; 0207/12
RELAY_DRIVER: 7405N; DIL14
SUPPLY: AK500/2-H
SUPPLY_1: AK500/2-H
TEST_POINTS: JP1Q; JP1
U1: TXS0108E_PW_20; PW20

Connections:
+5V: D1.C, D2.C, GATE_DRIVER.14 (VCC), K1.16 (2), K2.16 (2), LM35.1, LM35.2, RELAY_DRIVER.14 (+UB), SUPPLY.1, U1.19 (V); also elsewhere on the board
+12V: FAN.1, INDUCTOR.1, R1.1, SUPPLY_1.1
GND: D3.C, FAN.2, GATE_DRIVER.7 (GND), Q1.S, Q2.S, R2.1, R3.1, RELAY_DRIVER.7 (-UB), SUPPLY.2, SUPPLY_1.2, U1.11 (GND); also elsewhere on the board
IN+: CONTROLS.1, INA_IN.2; also elsewhere on the board
IN-: INA_IN.1, K1.P1, K2.P1; also elsewhere on the board
unnamed: LSJ1.3, PWM_RELAY_IN.2, U1.3 (A2)
unnamed: D2.A, K2.1, RELAY_DRIVER.4 (Y)
unnamed: LM35.3, LM35.4, R3.2
unnamed: D1.A, K1.1, RELAY_DRIVER.2 (Y)
unnamed: GATE_DRIVER.2 (O), Q1.G, Q2.G, R1.2, R2.2, TEST_POINTS.2
unnamed: D4.A, LM35.5, LM35.6
unnamed: D3.A, D4.C
unnamed: LSJ1.4, U1.1 (A1)
unnamed: LSJ4.1, U1.20 (B1)
unnamed: CONTROLS.2, K1.P2, K2.P2
unnamed: C1.-, K1.O2 (O), K1.S1 (S), K2.O2 (O), K2.S1 (S), Q1.D, Q2.D, TEST_POINTS.1
unnamed: LSJ1.2, PWM_RELAY_IN.1, U1.4 (A3)
unnamed: LSJ1.1, U1.5 (A4)
unnamed: LSJ2.4, U1.6 (A5)
unnamed: LSJ2.3, U1.7 (A6)
unnamed: LSJ2.2, U1.8 (A7)
unnamed: LSJ2.1, U1.9 (A8)
unnamed: LSIN.2, U1.10 (OE)
unnamed: LSIN.1, LSIN.3, U1.2 (VCCA)
unnamed: LSJ4.2, RELAY_DRIVER.1 (A), RELAY_DRIVER.3 (A), U1.18 (B2)
unnamed: GATE_DRIVER.1 (I), LSJ4.3, U1.17 (B3)
unnamed: LSJ4.4, U1.16 (B4)
unnamed: LSJ3.1, U1.15 (B5)
unnamed: LSJ3.2, U1.14 (B6)
unnamed: LSJ3.3, U1.13 (B7)
unnamed: LSJ3.4, U1.12 (B8)
VBUS: C1.+, INDUCTOR.2, K1.O1 (O), K1.S2 (S), K2.O1 (O), K2.S2 (S); also elsewhere on the board

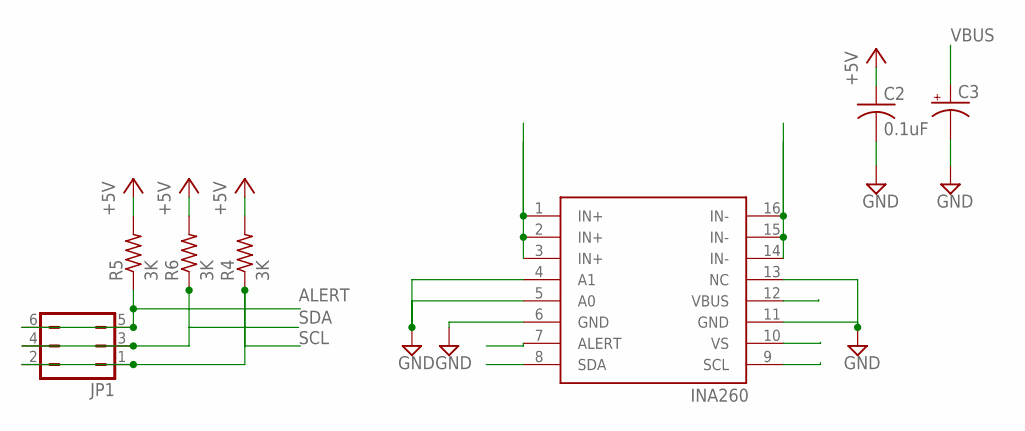
[picture p78: schematic Peltier_Controller.sch, sheet 2]

Parts:
C2: 0.1uF; C050-025X075
C3: CPOL-USE5-10.5; E5-10,5
JP1: JP3Q
R4, R5, R6: 3K; 0207/10
U$1: INA260; TSSOP16

Connections:
+5V: C2.1, R4.2, R5.2, R6.2, U$1.10 (VS); also elsewhere on the board
ALERT: JP1.5, JP1.6, R5.1, U$1.7 (ALERT)
GND: C2.2, C3.-, U$1.4 (A1), U$1.5 (A0), U$1.6 (GND), U$1.11 (GND), U$1.13 (NC); also elsewhere on the board
IN+: U$1.1 (IN+), U$1.2 (IN+), U$1.3 (IN+); also elsewhere on the board
IN-: U$1.14 (IN-), U$1.15 (IN-), U$1.16 (IN-); also elsewhere on the board
SCL: JP1.1, JP1.2, R4.1, U$1.9 (SCL)
SDA: JP1.3, JP1.4, R6.1, U$1.8 (SDA)
VBUS: C3.+, U$1.12 (VBUS); also elsewhere on the board

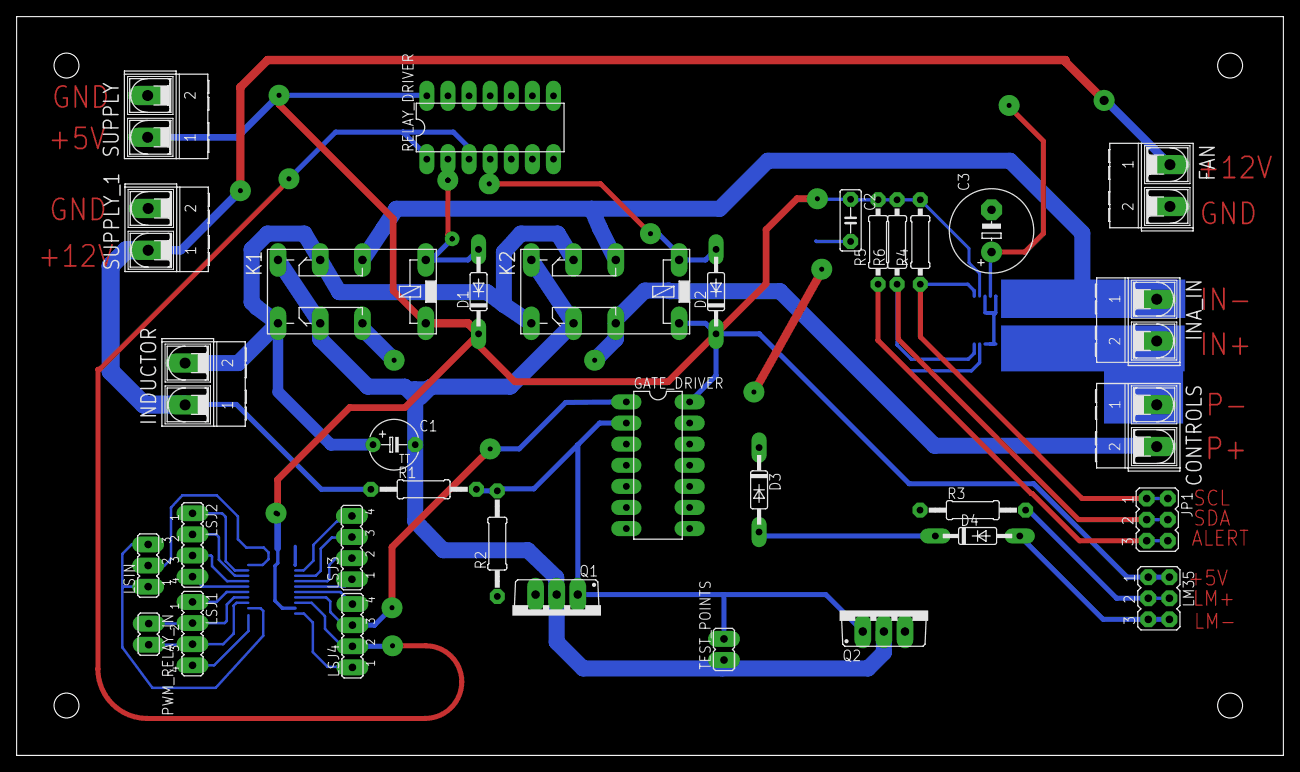
[picture p79: board Peltier_Controller.brd from above]

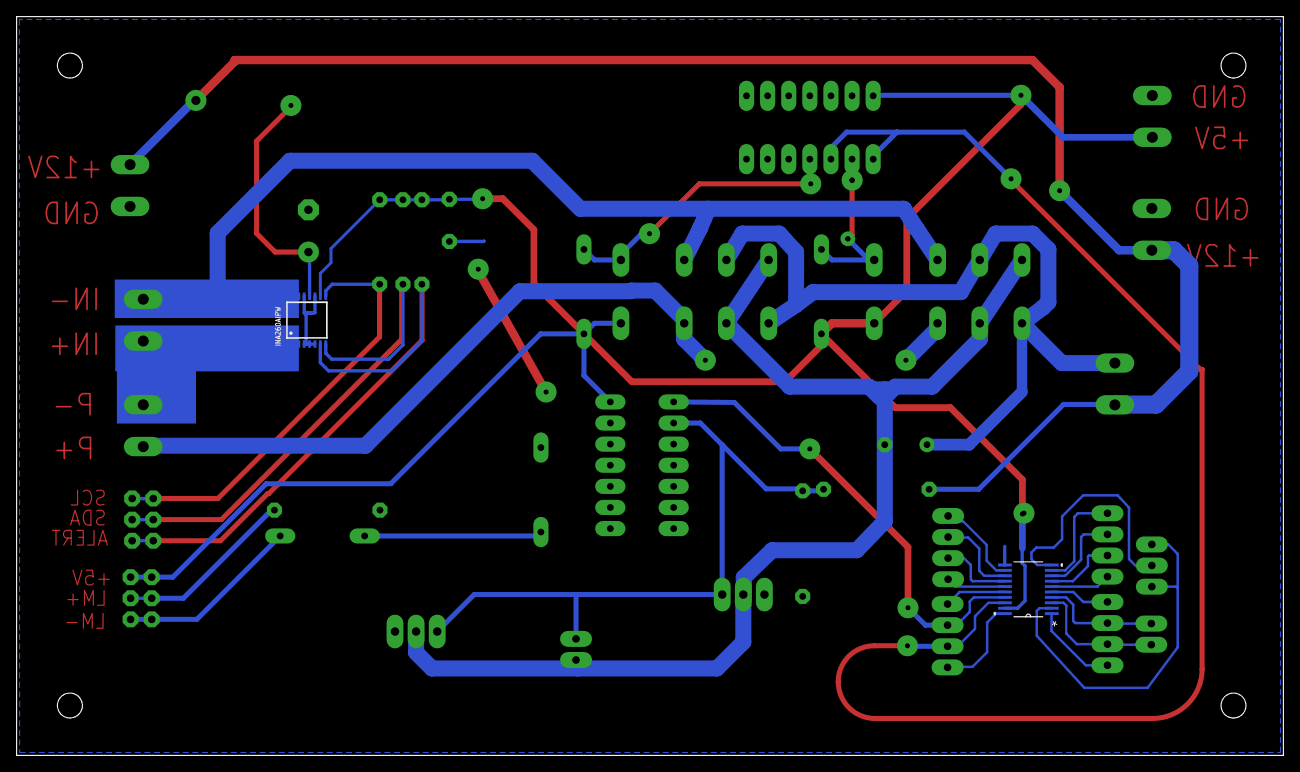
[picture p80: board Peltier_Controller.brd from below]

Board: 2 copper layers, 152.4 x 88.9 mm, 36 parts (2 on the bottom side), 35 nets.
