ymahajan456/Peltier-and-CHIL/Boards/IV_Characteristics/IV.brd

## EAGLE design Boards/IV_Characteristics/IV.brd (2018-08-11)

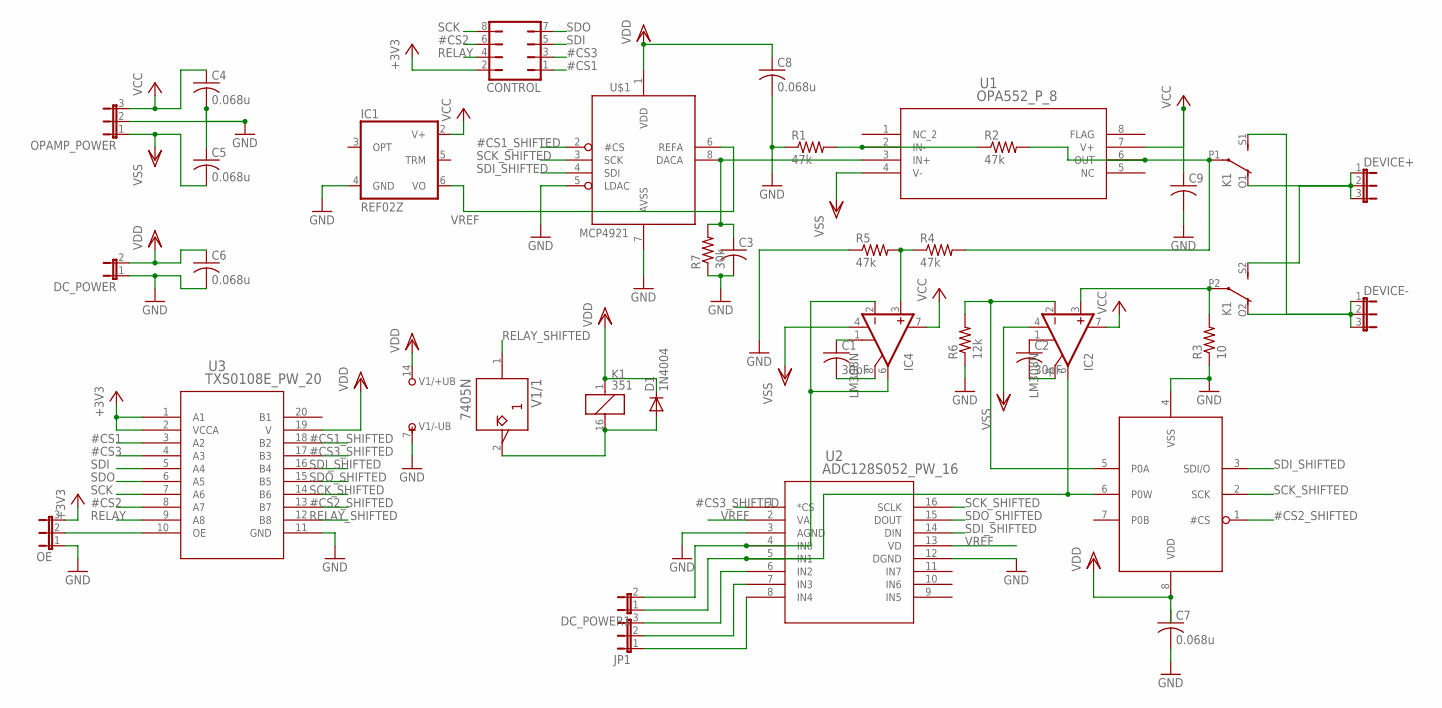
[picture p81: schematic IV.sch]

Parts:
C1, C2: 30pF; C050-035X075
C3, C9: C-US050-035X075; C050-035X075
C4, C5, C6, C7, C8: 0.068u; C050-035X075
CONTROL: JP4Q
D1: 1N4004; DO41-10
DC_POWER, DC_POWER1: JP1E; JP1
DEVICE+: JP2E; JP2
DEVICE-: JP2E; JP2
IC1: REF02Z; DIL08
IC2, IC4: LM308N; DIL08
JP1: JP2E; JP2
K1: 351
OE: JP2E; JP2
OPAMP_POWER: JP2E; JP2
R1, R2, R4, R5: 47k; 0207/10
R3: 10; 0207/10
R6: 12k; 0207/10
R7: 30k; 0207/10
U1: OPA552_P_8; P8
U2: ADC128S052_PW_16; MTC16
U3: TXS0108E_PW_20; PW20
U$1: MCP4921; DIL08
U$2: MCP4161; DIL08
V1: 7405N; DIL14

Connections:
#CS1: CONTROL.1, U3.3 (A2)
#CS1_SHIFTED: U3.18 (B2), U$1.2 (#CS)
#CS2: CONTROL.6, U3.8 (A7)
#CS2_SHIFTED: U3.13 (B7), U$2.1 (#CS)
#CS3: CONTROL.3, U3.4 (A3)
#CS3_SHIFTED: U2.1 (*CS), U3.17 (B3)
+3V3: CONTROL.2, OE.3, U3.1 (A1), U3.2 (VCCA)
GND: C3.2, C4.2, C5.1, C6.2, C7.2, C8.2, C9.2, DC_POWER.1, IC1.4 (GND), OE.1, OPAMP_POWER.2, R1.1, R3.1, R5.1, R6.1, R7.1, U2.3 (AGND), U2.12 (DGND), U3.11 (GND), U$1.5 (LDAC), U$1.7 (AVSS), U$2.4 (VSS), V1.7 (-UB)
unnamed: DC_POWER1.1, IC2.6 (OUT), U2.5 (IN1), U$2.6 (P0W)
unnamed: DC_POWER1.2, IC4.2 (-IN), IC4.6 (OUT), U2.4 (IN0)
unnamed: JP1.3, U2.6 (IN2)
unnamed: JP1.2, U2.7 (IN3)
unnamed: JP1.1, U2.8 (IN4)
unnamed: C3.1, R7.2, U1.3 (IN+), U$1.8 (DACA)
unnamed: R1.2, R2.1, U1.2 (IN-)
unnamed: K1.P1, R2.2, R4.2, U1.6 (OUT)
unnamed: D1.A, K1.16 (2), V1.2 (Y)
unnamed: IC2.3 (+IN), K1.P2, R3.2
unnamed: DEVICE+.1, DEVICE+.2, DEVICE+.3, K1.O1 (O), K1.S2 (S)
unnamed: DEVICE-.1, DEVICE-.2, DEVICE-.3, K1.O2 (O), K1.S1 (S)
unnamed: OE.2, U3.10 (OE)
unnamed: IC4.3 (+IN), R4.1, R5.2
unnamed: C1.1, IC4.1 (CMP1)
unnamed: IC2.2 (-IN), R6.2, U$2.5 (P0A)
unnamed: C1.2, IC4.8 (CMP2)
unnamed: C2.1, IC2.1 (CMP1)
unnamed: C2.2, IC2.8 (CMP2)
RELAY: CONTROL.4, U3.9 (A8)
RELAY_SHIFTED: U3.12 (B8), V1.1 (A)
SCK: CONTROL.8, U3.7 (A6)
SCK_SHIFTED: U2.16 (SCLK), U3.14 (B6), U$1.3 (SCK), U$2.2 (SCK)
SDI: CONTROL.5, U3.5 (A4)
SDI_SHIFTED: U2.14 (DIN), U3.16 (B4), U$1.4 (SDI), U$2.3 (SDI/O)
SDO: CONTROL.7, U3.6 (A5)
SDO_SHIFTED: U2.15 (DOUT), U3.15 (B5)
VCC: C4.1, C9.1, IC1.2 (V+), IC2.7 (V+), IC4.7 (V+), OPAMP_POWER.3, U1.7 (V+)
VDD: C6.1, C7.1, C8.1, D1.C, DC_POWER.2, K1.1, U3.19 (V), U$1.1 (VDD), U$2.8 (VDD), V1.14 (+UB)
VREF: IC1.6 (VO), U2.2 (VA), U2.13 (VD), U$1.6 (REFA)
VSS: C5.2, IC2.4 (V-), IC4.4 (V-), OPAMP_POWER.1, U1.4 (V-)

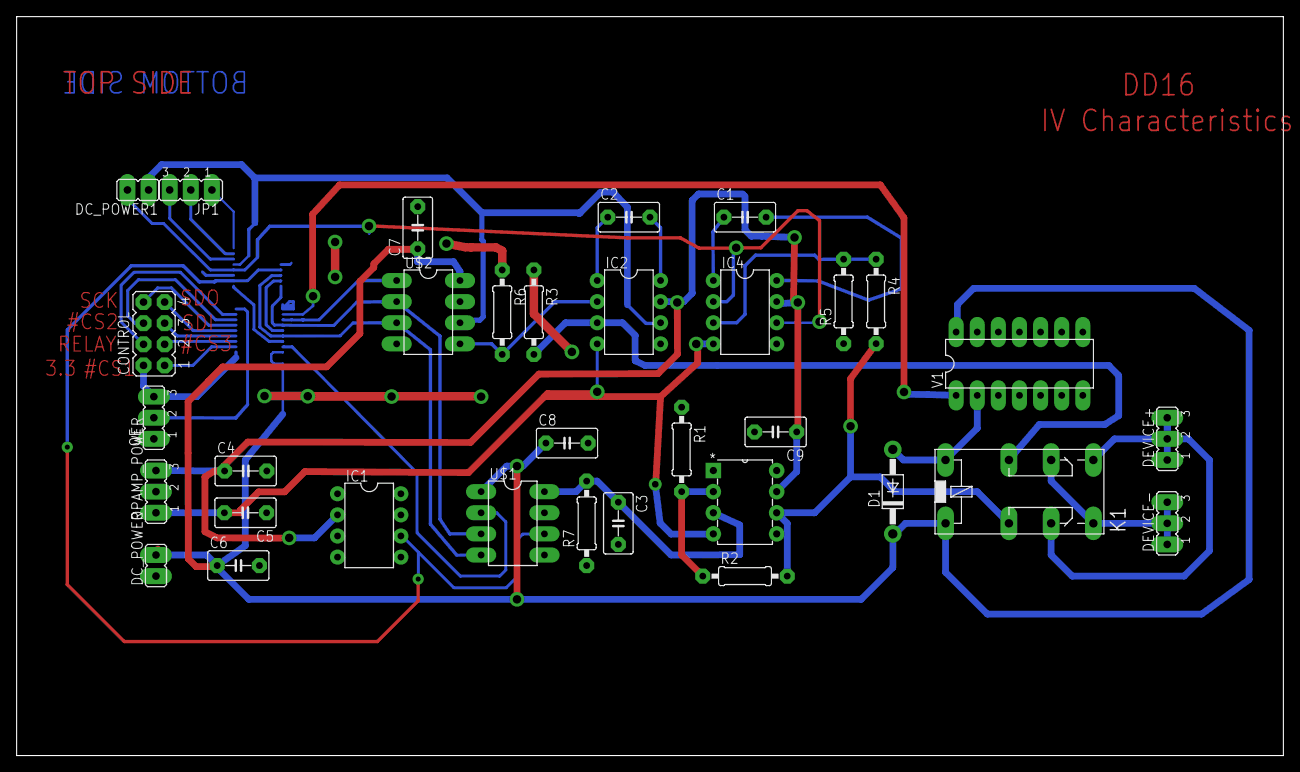
[picture p82: board IV.brd from above]

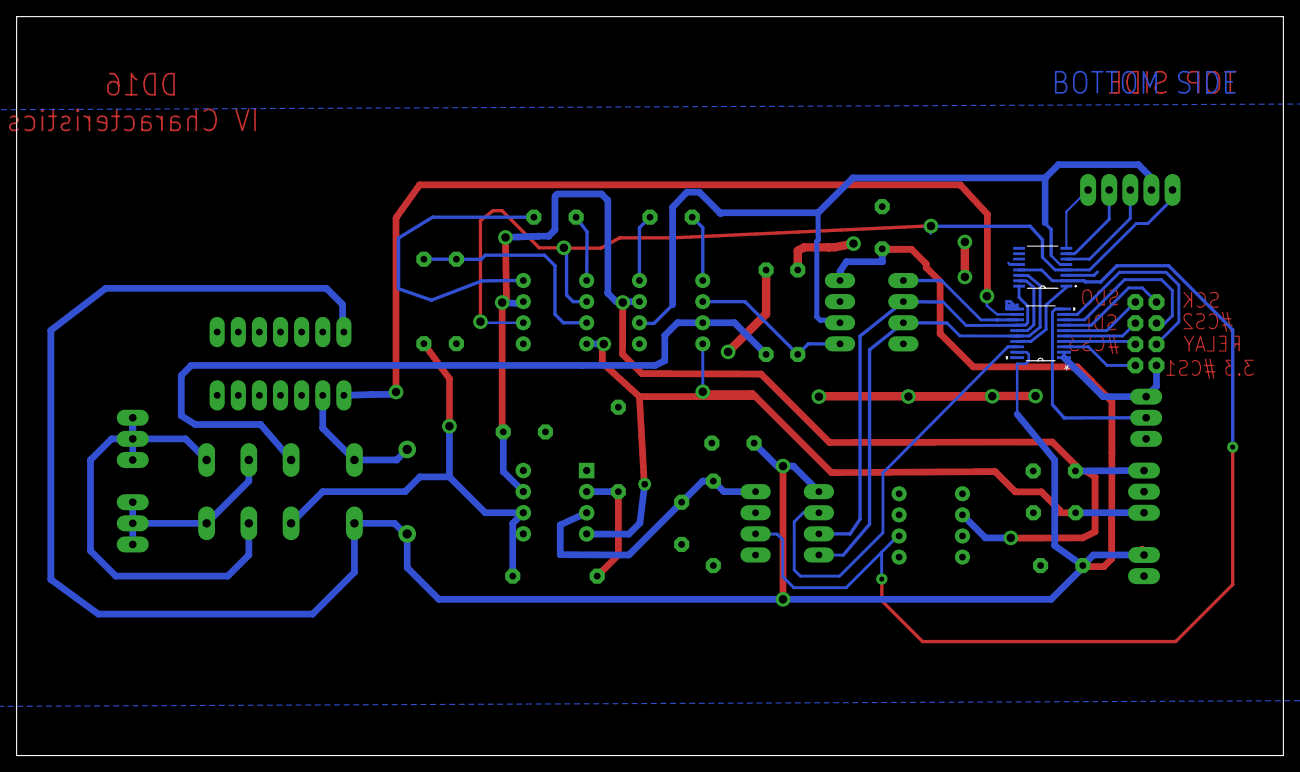
[picture p83: board IV.brd from below]

Board: 2 copper layers, 152.4 x 88.9 mm, 35 parts (2 on the bottom side), 39 nets.
