ymahajan456/Peltier-and-CHIL/Boards/Test Boards/DRV592/drv592.brd

## EAGLE design Boards/Test Boards/DRV592/drv592.brd (2018-08-11)

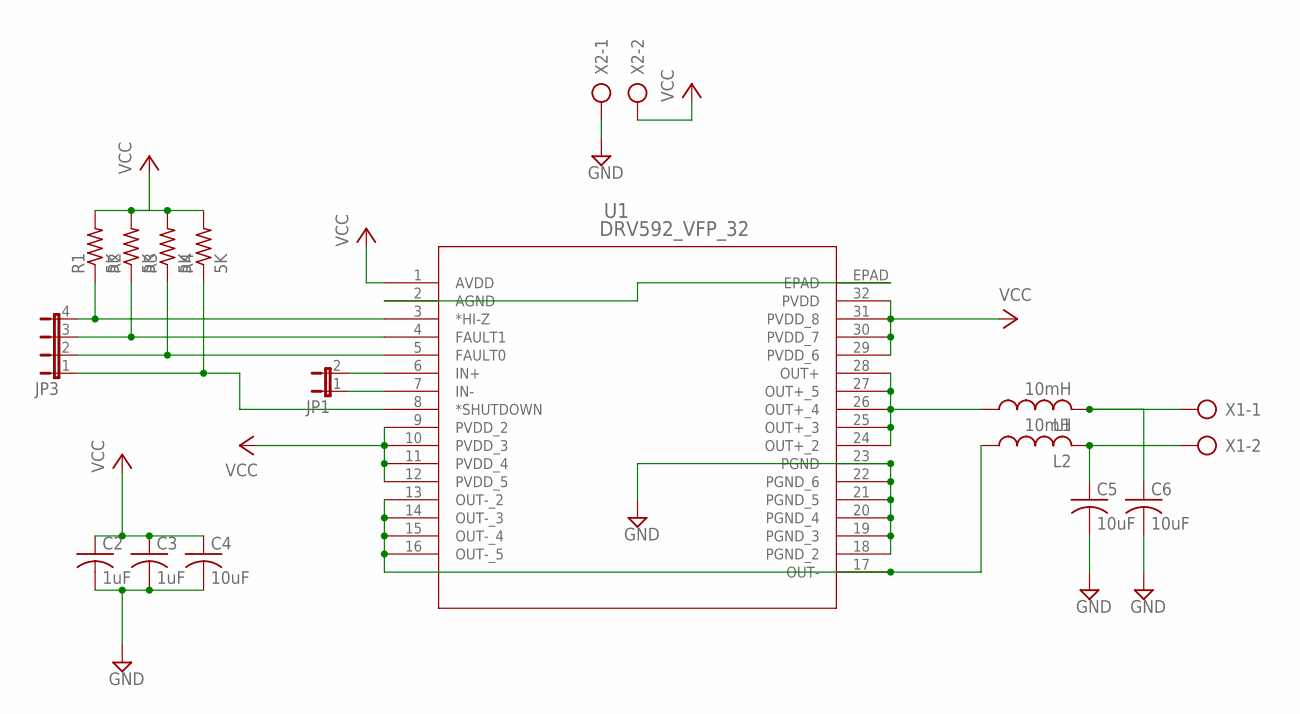
[picture p84: schematic drv592.sch]

Parts:
C2, C3: 1uF; C050-030X075
C4, C5, C6: 10uF; C050-030X075
JP1: JP1E; JP1
JP3: JP4E; JP4
L1, L2: 10mH; TJ3-U2
R1, R2, R3, R4: 5K; 0207/10
U1: DRV592_VFP_32; VFP32_3P91X3P91
X1, X2: AK300/2

Connections:
GND: C2.2, C3.2, C4.2, C5.2, C6.2, U1.18 (PGND_2), U1.19 (PGND_3), U1.20 (PGND_4), U1.21 (PGND_5), U1.22 (PGND_6), U1.23 (PGND), X2.1
unnamed: L1.1, U1.24 (OUT+_2), U1.25 (OUT+_3), U1.26 (OUT+_4), U1.27 (OUT+_5), U1.28 (OUT+)
unnamed: C5.1, L2.2, X1.2
unnamed: L2.1, U1.13 (OUT-_2), U1.14 (OUT-_3), U1.15 (OUT-_4), U1.16 (OUT-_5), U1.17 (OUT-)
unnamed: C6.1, L1.2, X1.1
unnamed: JP1.2, U1.6 (IN+)
unnamed: JP1.1, U1.7 (IN-)
unnamed: JP3.4, R1.1, U1.3 (*HI-Z)
unnamed: JP3.3, R2.1, U1.4 (FAULT1)
unnamed: JP3.2, R3.1, U1.5 (FAULT0)
unnamed: JP3.1, R4.1, U1.8 (*SHUTDOWN)
unnamed: U1.2 (AGND), U1.EPAD
VCC: C2.1, C3.1, C4.1, R1.2, R2.2, R3.2, R4.2, U1.1 (AVDD), U1.9 (PVDD_2), U1.10 (PVDD_3), U1.11 (PVDD_4), U1.12 (PVDD_5), U1.29 (PVDD_6), U1.30 (PVDD_7), U1.31 (PVDD_8), U1.32 (PVDD), X2.2

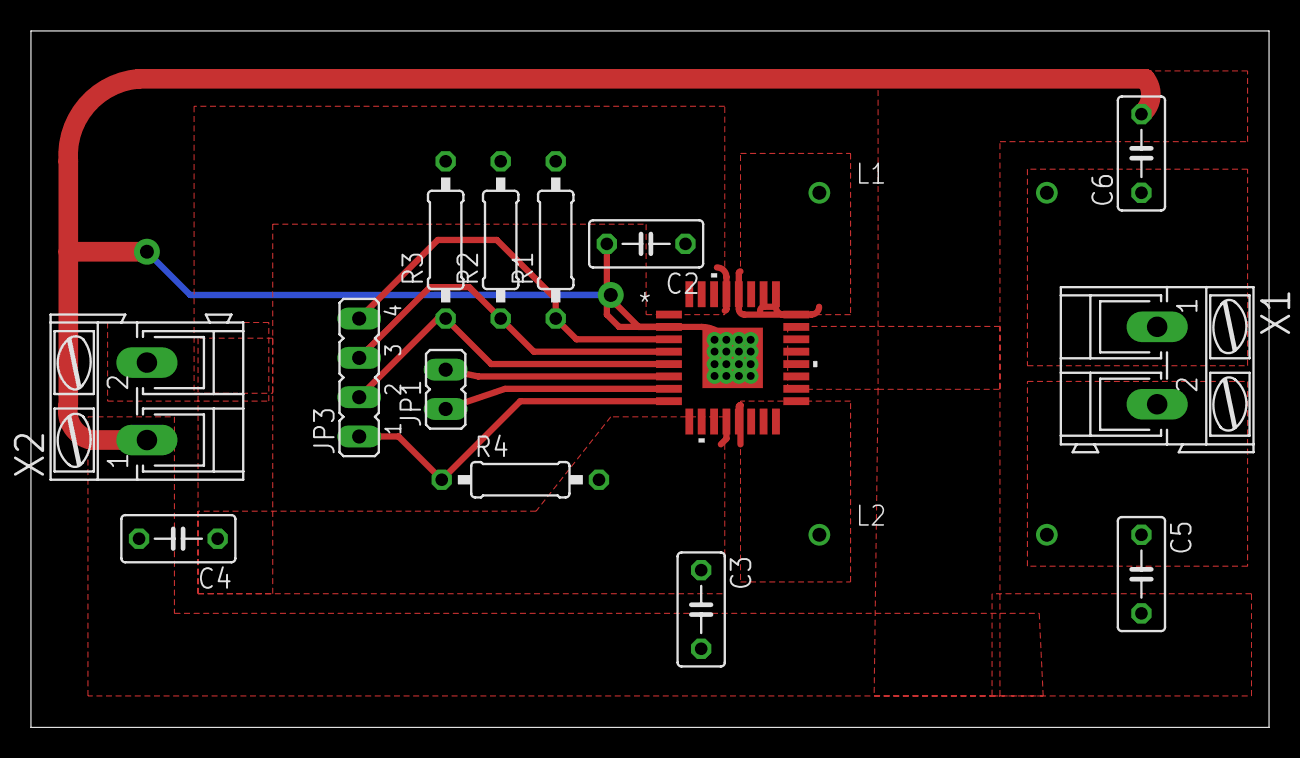
[picture p85: board drv592.brd from above]

Board: 2 copper layers, 80.0 x 45.0 mm, 16 parts (0 on the bottom side), 13 nets.
