ymahajan456/Peltier-and-CHIL/Boards/Test Boards/voltage_regulators/untitled.brd

## EAGLE design Boards/Test Boards/voltage_regulators/untitled.brd (2018-08-11)

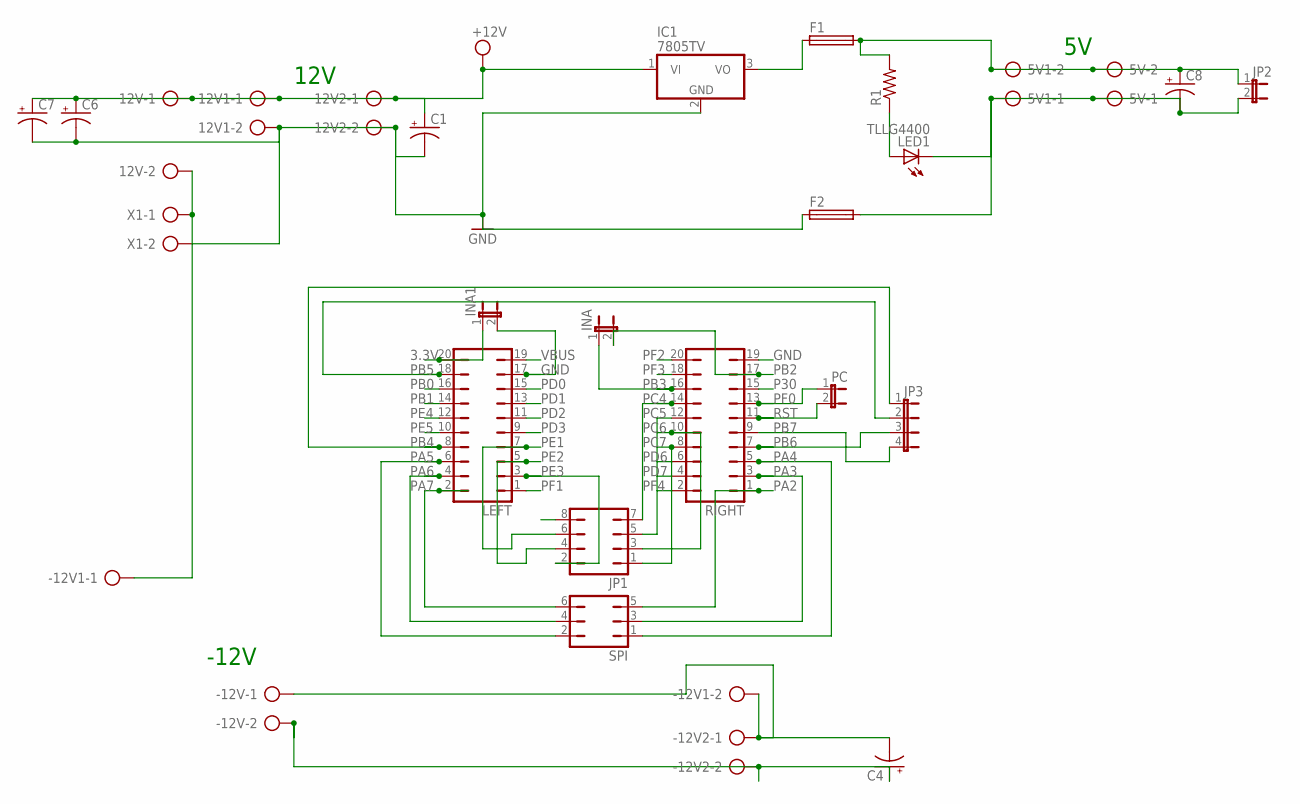
[picture p86: schematic untitled.sch]

Parts:
5V, 5V1, 12V, 12V1, 12V2: AK300/2
-12V, -12V1, -12V2: AK300/2
C1, C4, C6, C7, C8: CPOL-USE3.5-10; E3,5-10
F1, F2: GSH15
IC1: 7805TV; TO220V
INA, INA1: JP1E; JP1
JP1: JP4Q
JP2: JP1E; JP1
JP3: JP4E; JP4
LED1: TLLG4400; LED3MM
LEFT: JP10Q
PC: JP1E; JP1
R1: R-US_0207/10; 0207/10
RIGHT: JP10Q
SPI: JP3Q
X1: AK300/2

Connections:
3.3V: INA1.1, LEFT.20
GND: 12V1.2, 12V2.2, -12V.2, -12V2.2, C1.-, C4.+, C6.-, C7.-, F2.1, IC1.2 (GND), INA1.2, JP1.8, LEFT.17, RIGHT.19, X1.2
unnamed: F1.1, IC1.3 (VO)
unnamed: 5V.2, 5V1.2, C8.+, F1.2, JP2.1, R1.2
unnamed: 5V.1, 5V1.1, C8.-, F2.2, JP2.2, LED1.K (C)
unnamed: LED1.A, R1.1
unnamed: 12V.2, -12V1.1, X1.1
unnamed: -12V.1, -12V1.2, -12V2.1, C4.-
P30: RIGHT.15
PA2: RIGHT.1, SPI.5
PA3: RIGHT.3, SPI.3
PA4: RIGHT.5, SPI.1
PA5: LEFT.6, SPI.2
PA6: LEFT.4, SPI.4
PA7: LEFT.2, SPI.6
PB0: LEFT.16
PB1: LEFT.14
PB2: INA.2, RIGHT.17
PB3: INA.1, RIGHT.16
PB4: JP3.1, LEFT.8
PB5: JP3.2, LEFT.18
PB6: JP3.3, RIGHT.7
PB7: JP3.4, RIGHT.9
PC4: JP1.7, RIGHT.14
PC5: JP1.5, RIGHT.12
PC6: JP1.3, RIGHT.10
PC7: JP1.1, RIGHT.8
PD0: LEFT.15
PD1: LEFT.13
PD2: LEFT.11
PD3: LEFT.9
PD6: RIGHT.6
PD7: RIGHT.4
PE1: JP1.6, LEFT.7
PE2: JP1.4, LEFT.5
PE3: JP1.2, LEFT.3
PE4: LEFT.12
PE5: LEFT.10
PF0: PC.1, RIGHT.13
PF1: LEFT.1
PF2: RIGHT.20
PF3: RIGHT.18
PF4: RIGHT.2
RST: PC.2, RIGHT.11
VBUS: LEFT.19
VDD: 12V.1, 12V1.1, 12V2.1, C1.+, C6.+, C7.+, IC1.1 (VI)

Notes on the sheet:
12V
-12V

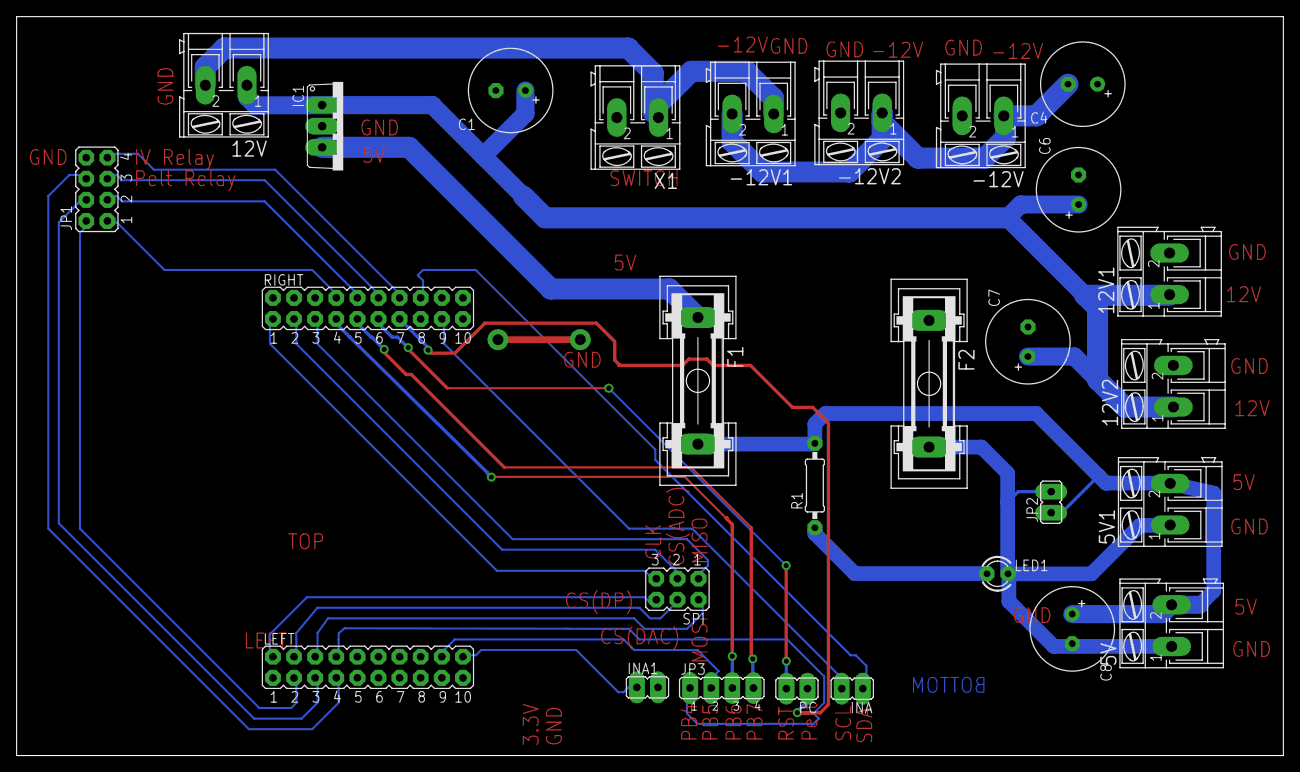
[picture p87: board untitled.brd from above]

Board: 2 copper layers, 152.4 x 88.9 mm, 28 parts (0 on the bottom side), 30 nets.
