ymahajan456/Peltier-and-CHIL/Codes/TivaC_tests/Workign With Includes/test_UART_include.c

#include "basic_includes.h"
#define DEFINE_VARIABLES
#include "TivaC_USB.h"
#include "TivaC_LED.h"
#include "TivaC_UART.h"
//#include "int_handlers.c"
uint32_t sent;
int main()
{
    ROM_SysCtlClockSet(SYSCTL_SYSDIV_4|SYSCTL_USE_PLL|SYSCTL_XTAL_16MHZ|SYSCTL_OSC_MAIN);
    PWMSetLeds(1000);
    SysCtlDelay(5000000);
    initUART(115200);
    initUSB();
    SetLedColor(RED);
    SysCtlDelay(5000);
    while(1)
    {
        sent = UARTSend(UART0_BASE,(uint8_t *)"\nSending...\n",strlen("\nSending...\n"));
        SysCtlDelay(50000000);
    }
}
