ymahajan456/Peltier-and-CHIL/(notices)

Notices in the files:
parts and their libraries:
DRV595: COPYRIGHT: Copyright C 2016 Accelerated Designs. All rights reserved
